azonenberg/freesample/README.md

# freesample
High performance sampling oscilloscope based on INTEGRALSTICK
