azonenberg/freesample/boards/freesample/freesample.kicad_pcb

## KiCad design boards/freesample/freesample.kicad_pcb (2019-04-01)

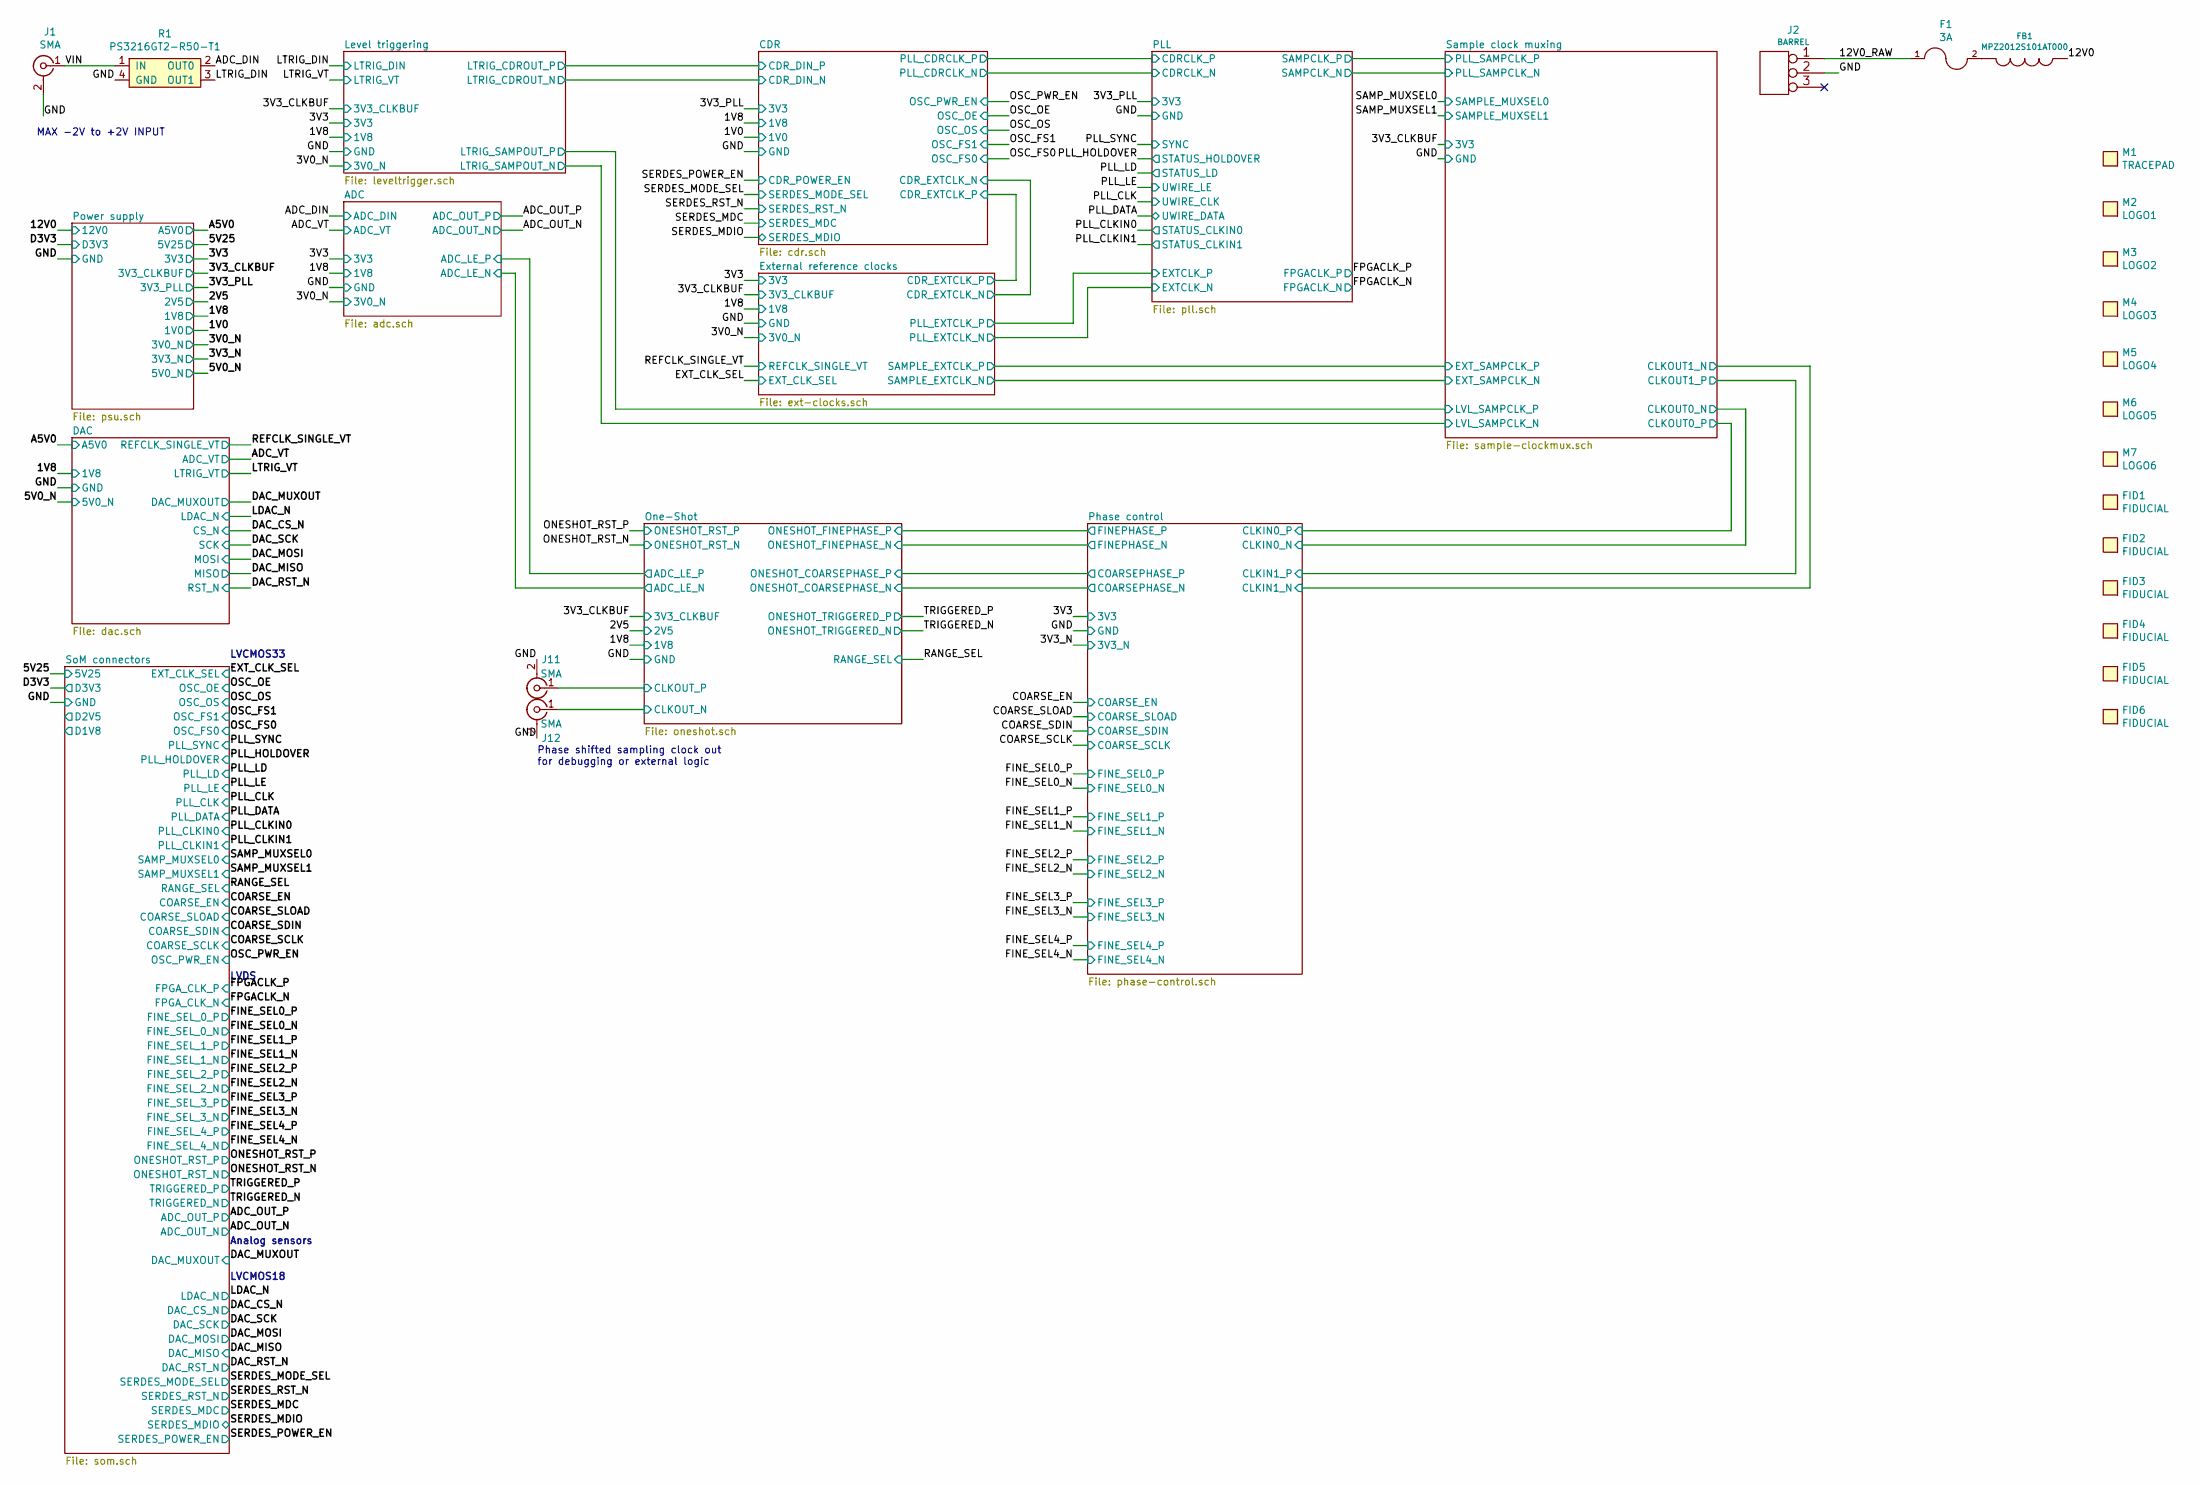
[picture p1: schematic freesample.sch, FREESAMPLE Oscilloscope]

Parts:
F1: 3A; EIA_0603_RES_NOSILK
FB1: MPZ2012S101AT000; EIA_0805_CAP_NOSILK
FID1, FID2, FID3, FID4, FID5, FID6: FIDUCIAL; FIDUCIAL_1MM
J1, J11, J12: SMA; CONN_SMA_EDGE_SAMTEC_SMA_J_P_H_ST_EM1
J2: BARREL; CONN_CUI_PJ-058BH_HIPWR_BARREL_NOSLOT
M1: TRACEPAD; SERIALNUM_MOLEX_0916580020
M2: LOGO1; LONGTHING-1200DPI
M3: LOGO2; Logo_silk_OSHW_6x6mm
M4: LOGO3; Logo_silk_polarity_center_5x1.4mm
M5: LOGO4; Logo_silk_ROHS_5x2.8mm
M6: LOGO5; Logo_silk_warning_5x4.2mm
M7: LOGO6; Logo_silk_WEEE_3.4x5mm
R1: PS3216GT2-R50-T1‎; SPLITTER_SUSUMU_PS3216G

Connections:
/12V0: FB1.1; also elsewhere on the board
/12V0_RAW: F1.1, J2.1
/ADC_DIN: R1.2 (OUT0); also elsewhere on the board
/GND: J1.2 (Ext), J2.2 (PM), J11.2 (Ext), J12.2 (Ext), R1.4 (GND); also elsewhere on the board
/LTRIG_DIN: R1.3 (OUT1); also elsewhere on the board
/One-Shot/CLKOUT_N: J12.1 (In); also elsewhere on the board
/One-Shot/CLKOUT_P: J11.1 (In); also elsewhere on the board
/VIN: J1.1 (In), R1.1 (IN)
unnamed: F1.2, FB1.2

Notes on the sheet:
LVCMOS33
Analog sensors
LVCMOS18
MAX -2V to +2V INPUT
LVDS
Phase shifted sampling clock out for debugging or external logic

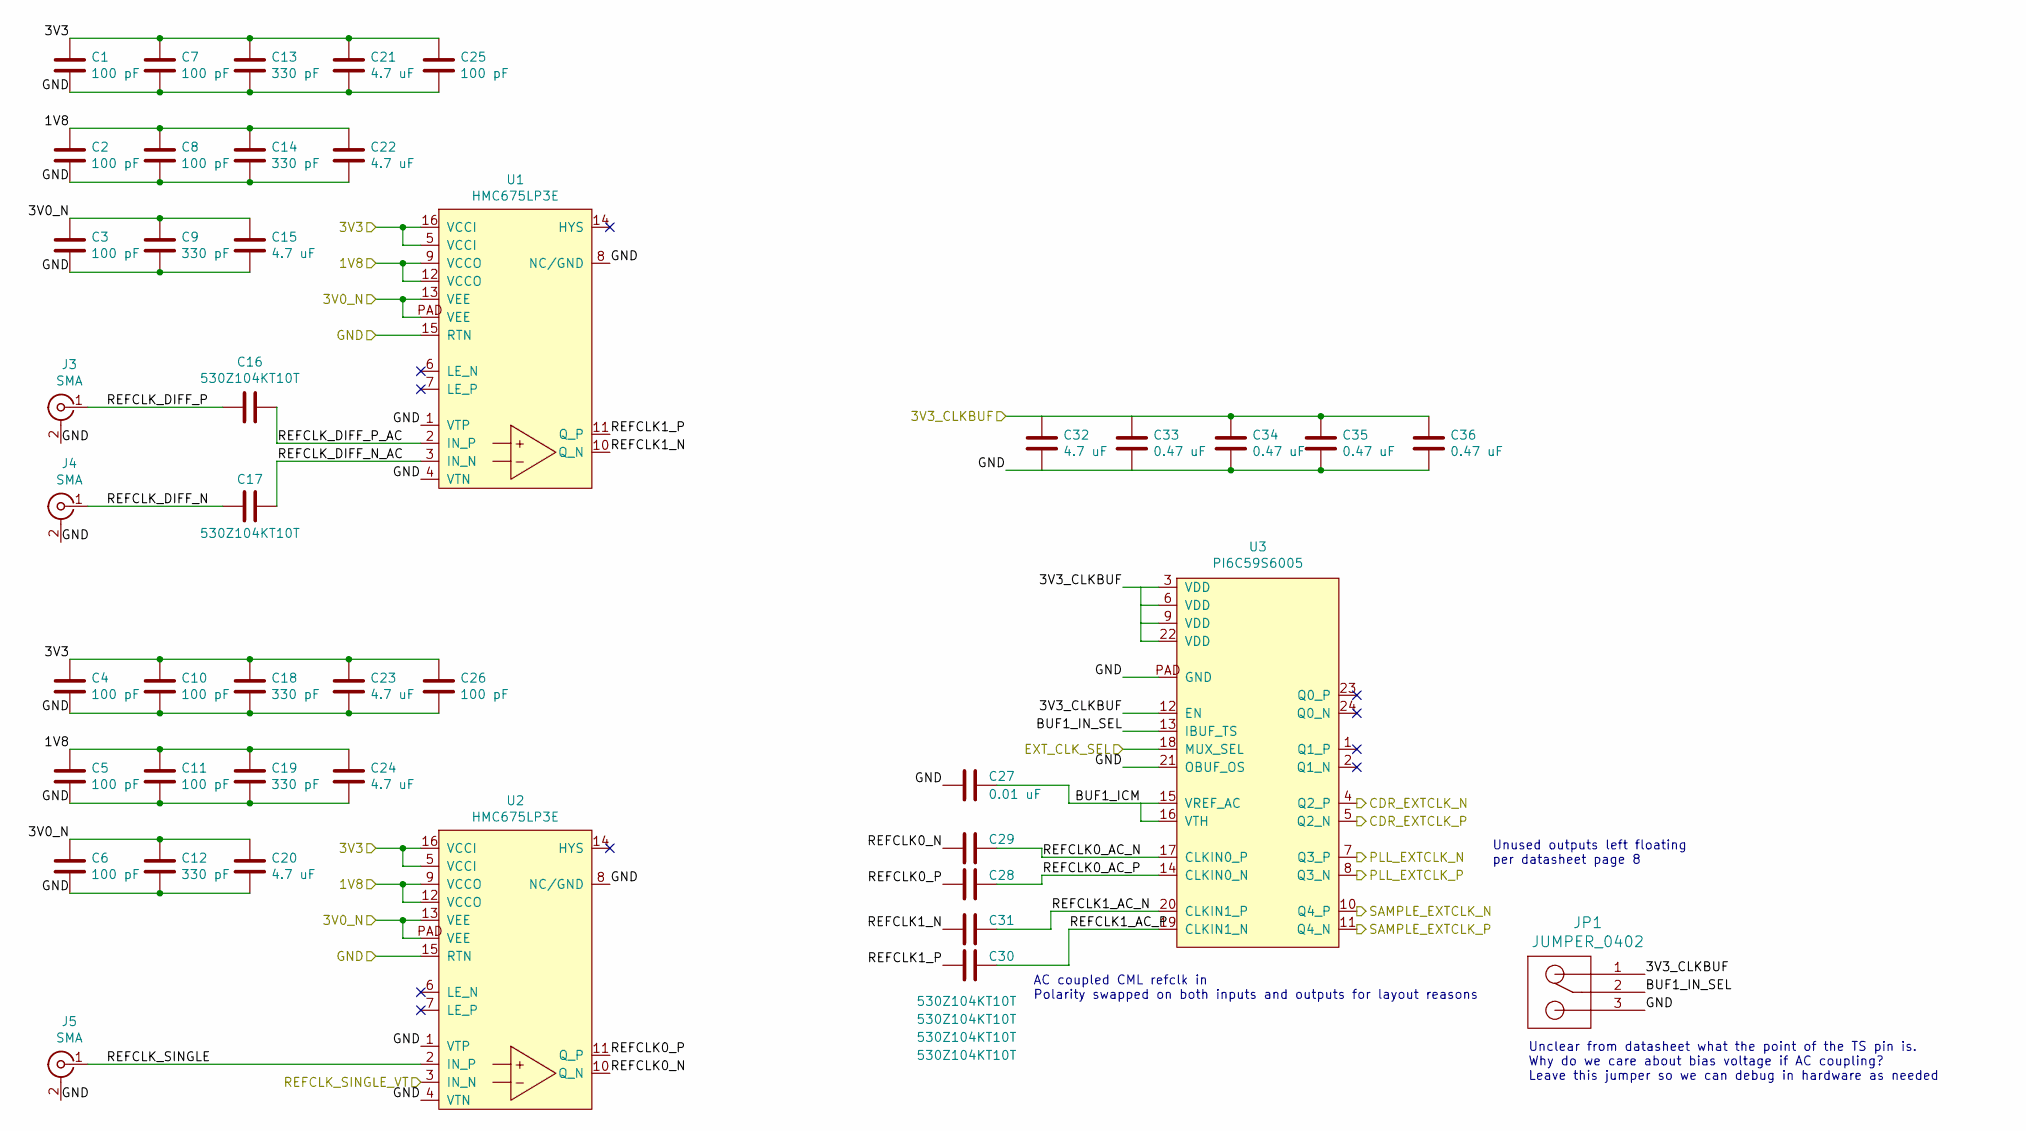
[picture p2: schematic ext-clocks.sch, FREESAMPLE Oscilloscope]

Parts:
C1, C2, C3, C4, C5, C6, C7, C8, C10, C11, C25, C26: 100 pF; EIA_0201_CAP_NOSILK
C9, C12, C13, C14, C18, C19: 330 pF; EIA_0201_CAP_NOSILK
C15, C20, C21, C22, C23, C24, C32: 4.7 uF; EIA_0603_CAP_NOSILK
C16, C17, C28, C29, C30, C31: 530Z104KT10T; EIA_0201_CAP_NOSILK
C27: 0.01 uF; EIA_0402_CAP_NOSILK
C33, C34, C35, C36: 0.47 uF; EIA_0402_CAP_NOSILK
J3, J4, J5: SMA; CONN_SMA_EDGE_SAMTEC_SMA_J_P_H_ST_EM1
JP1: JUMPER_0402; EIA_0402_JUMPER
U1, U2: HMC675LP3E; QFN_16_0.5MM_3x3MM
U3: PI6C59S6005; QFN_24_0.5MM_4x4MM

Connections:
/1V8: C2.1, C5.1, C8.1, C11.1, C14.1, C19.1, C22.1, C24.1, U1.9 (VCCO), U1.12 (VCCO), U2.9 (VCCO), U2.12 (VCCO); also elsewhere on the board
/3V0_N: C3.1, C6.1, C9.1, C12.1, C15.1, C20.1, U1.13 (VEE), U1.PAD (VEE), U2.13 (VEE), U2.PAD (VEE); also elsewhere on the board
/3V3: C1.1, C4.1, C7.1, C10.1, C13.1, C18.1, C21.1, C23.1, C25.1, C26.1, U1.5 (VCCI), U1.16 (VCCI), U2.5 (VCCI), U2.16 (VCCI); also elsewhere on the board
/3V3_CLKBUF: C32.1, C33.1, C34.1, C35.1, C36.1, JP1.1, U3.3 (VDD), U3.6 (VDD), U3.9 (VDD), U3.12 (EN), U3.22 (VDD); also elsewhere on the board
/CDR/CDR_EXTCLK_N: U3.4 (Q2_P); also elsewhere on the board
/CDR/CDR_EXTCLK_P: U3.5 (Q2_N); also elsewhere on the board
/EXT_CLK_SEL: U3.18 (MUX_SEL); also elsewhere on the board
/External reference clocks/BUF1_ICM: C27.1, U3.15 (VREF_AC), U3.16 (VTH)
/External reference clocks/BUF1_IN_SEL: JP1.2, U3.13 (IBUF_TS)
/External reference clocks/REFCLK0_AC_N: C29.1, U3.17 (CLKIN0_P)
/External reference clocks/REFCLK0_AC_P: C28.1, U3.14 (CLKIN0_N)
/External reference clocks/REFCLK0_N: C29.2, U2.10 (Q_N)
/External reference clocks/REFCLK0_P: C28.2, U2.11 (Q_P)
/External reference clocks/REFCLK1_AC_N: C31.1, U3.20 (CLKIN1_P)
/External reference clocks/REFCLK1_AC_P: C30.1, U3.19 (CLKIN1_N)
/External reference clocks/REFCLK1_N: C31.2, U1.10 (Q_N)
/External reference clocks/REFCLK1_P: C30.2, U1.11 (Q_P)
/External reference clocks/REFCLK_DIFF_N: C17.2, J4.1 (In)
/External reference clocks/REFCLK_DIFF_N_AC: C17.1, U1.3 (IN_N)
/External reference clocks/REFCLK_DIFF_P: C16.2, J3.1 (In)
/External reference clocks/REFCLK_DIFF_P_AC: C16.1, U1.2 (IN_P)
/External reference clocks/REFCLK_SINGLE: J5.1 (In), U2.2 (IN_P)
/GND: C1.2, C2.2, C3.2, C4.2, C5.2, C6.2, C7.2, C8.2, C9.2, C10.2, C11.2, C12.2, C13.2, C14.2, C15.2, C18.2, C19.2, C20.2, C21.2, C22.2, C23.2, C24.2, C25.2, C26.2, C27.2, C32.2, C33.2, C34.2, C35.2, C36.2, J3.2 (Ext), J4.2 (Ext), J5.2 (Ext), JP1.3, U1.1 (VTP), U1.4 (VTN), U1.8 (NC/GND), U1.15 (RTN), U2.1 (VTP), U2.4 (VTN), U2.8 (NC/GND), U2.15 (RTN), U3.21 (OBUF_OS), U3.PAD (GND); also elsewhere on the board
/PLL/EXTCLK_N: U3.7 (Q3_P); also elsewhere on the board
/PLL/EXTCLK_P: U3.8 (Q3_N); also elsewhere on the board
/REFCLK_SINGLE_VT: U2.3 (IN_N); also elsewhere on the board
/Sample clock muxing/EXT_SAMPCLK_N: U3.10 (Q4_P); also elsewhere on the board
/Sample clock muxing/EXT_SAMPCLK_P: U3.11 (Q4_N); also elsewhere on the board

Notes on the sheet:
AC coupled CML refclk in Polarity swapped on both inputs and outputs for layout reasons
Unused outputs left floating per datasheet page 8
Unclear from datasheet what the point of the TS pin is. Why do we care about bias voltage if AC coupling? Leave this jumper so we can debug in hardware as needed

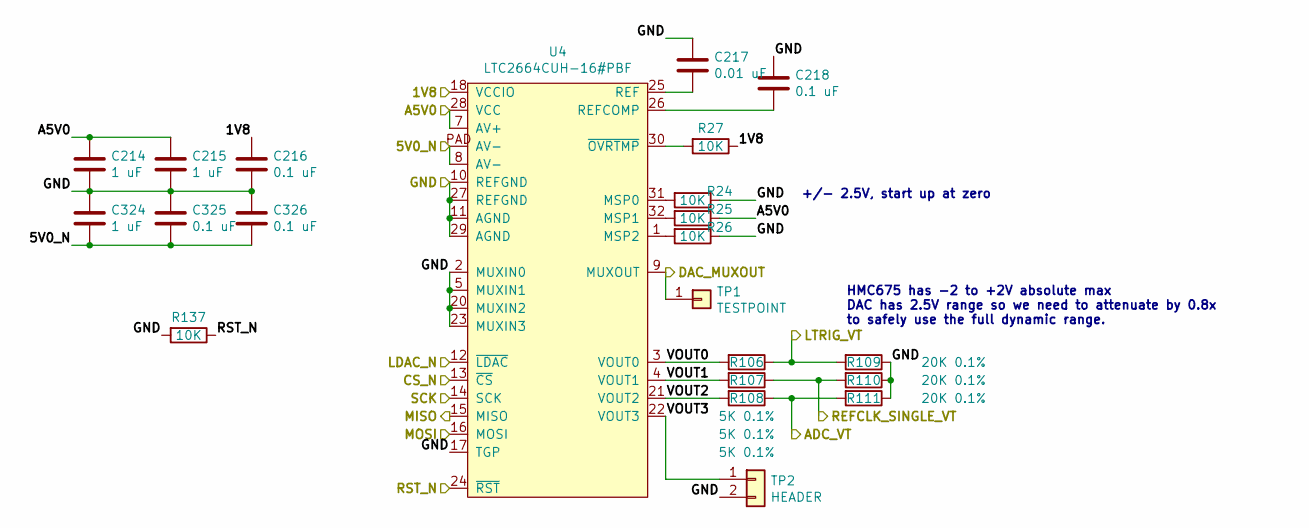
[picture p3: schematic dac.sch, FREESAMPLE Oscilloscope]

Parts:
C214, C215, C324: 1 uF; EIA_0603_CAP_NOSILK
C216, C218, C325, C326: 0.1 uF; EIA_0402_CAP_NOSILK
C217: 0.01 uF; EIA_0402_CAP_NOSILK
R24, R25, R26, R27, R137: 10K; EIA_0402_RES_NOSILK
R106, R107, R108: 5K 0.1%; EIA_0402_RES_NOSILK
R109, R110, R111: 20K 0.1%; EIA_0402_RES_NOSILK
TP1: TESTPOINT; TESTPOINT_SMT_KEYSTONE_5016
TP2: HEADER; CONN_HEADER_2.54MM_1x2
U4: LTC2664CUH-16#PBF; QFN_32_0.5MM_5x5MM

Connections:
/1V8: C216.1, R27.1, U4.18 (VCCIO); also elsewhere on the board
/5V0_N: C324.2, C325.2, C326.2, U4.8 (AV-), U4.PAD (AV-); also elsewhere on the board
/A5V0: C214.1, C215.1, R25.1, U4.7 (AV+), U4.28 (VCC); also elsewhere on the board
/ADC_VT: R108.1, R111.2; also elsewhere on the board
/DAC/VOUT0: R106.2, U4.3 (VOUT0)
/DAC/VOUT1: R107.2, U4.4 (VOUT1)
/DAC/VOUT2: R108.2, U4.21 (VOUT2)
/DAC/VOUT3: TP2.1, U4.22 (VOUT3)
/DAC_CS_N: U4.13 (~CS); also elsewhere on the board
/DAC_MISO: U4.15 (MISO); also elsewhere on the board
/DAC_MOSI: U4.16 (MOSI); also elsewhere on the board
/DAC_MUXOUT: TP1.1, U4.9 (MUXOUT); also elsewhere on the board
/DAC_RST_N: R137.1, U4.24 (~RST); also elsewhere on the board
/DAC_SCK: U4.14 (SCK); also elsewhere on the board
/GND: C214.2, C215.2, C216.2, C217.1, C218.1, C324.1, C325.1, C326.1, R24.1, R26.1, R109.1, R110.1, R111.1, R137.2, TP2.2, U4.2 (MUXIN0), U4.5 (MUXIN1), U4.10 (REFGND), U4.11 (AGND), U4.17 (TGP), U4.20 (MUXIN2), U4.23 (MUXIN3), U4.27 (REFGND), U4.29 (AGND); also elsewhere on the board
/LDAC_N: U4.12 (~LDAC); also elsewhere on the board
/LTRIG_VT: R106.1, R109.2; also elsewhere on the board
/REFCLK_SINGLE_VT: R107.1, R110.2; also elsewhere on the board
unnamed: C217.2, U4.25 (REF)
unnamed: C218.2, U4.26 (REFCOMP)
unnamed: R24.2, U4.31 (MSP0)
unnamed: R25.2, U4.32 (MSP1)
unnamed: R26.2, U4.1 (MSP2)
unnamed: R27.2, U4.30 (~OVRTMP)

Notes on the sheet:
+/- 2.5V, start up at zero
HMC675 has -2 to +2V absolute max DAC has 2.5V range so we need to attenuate by 0.8x to safely use the full dynamic range.

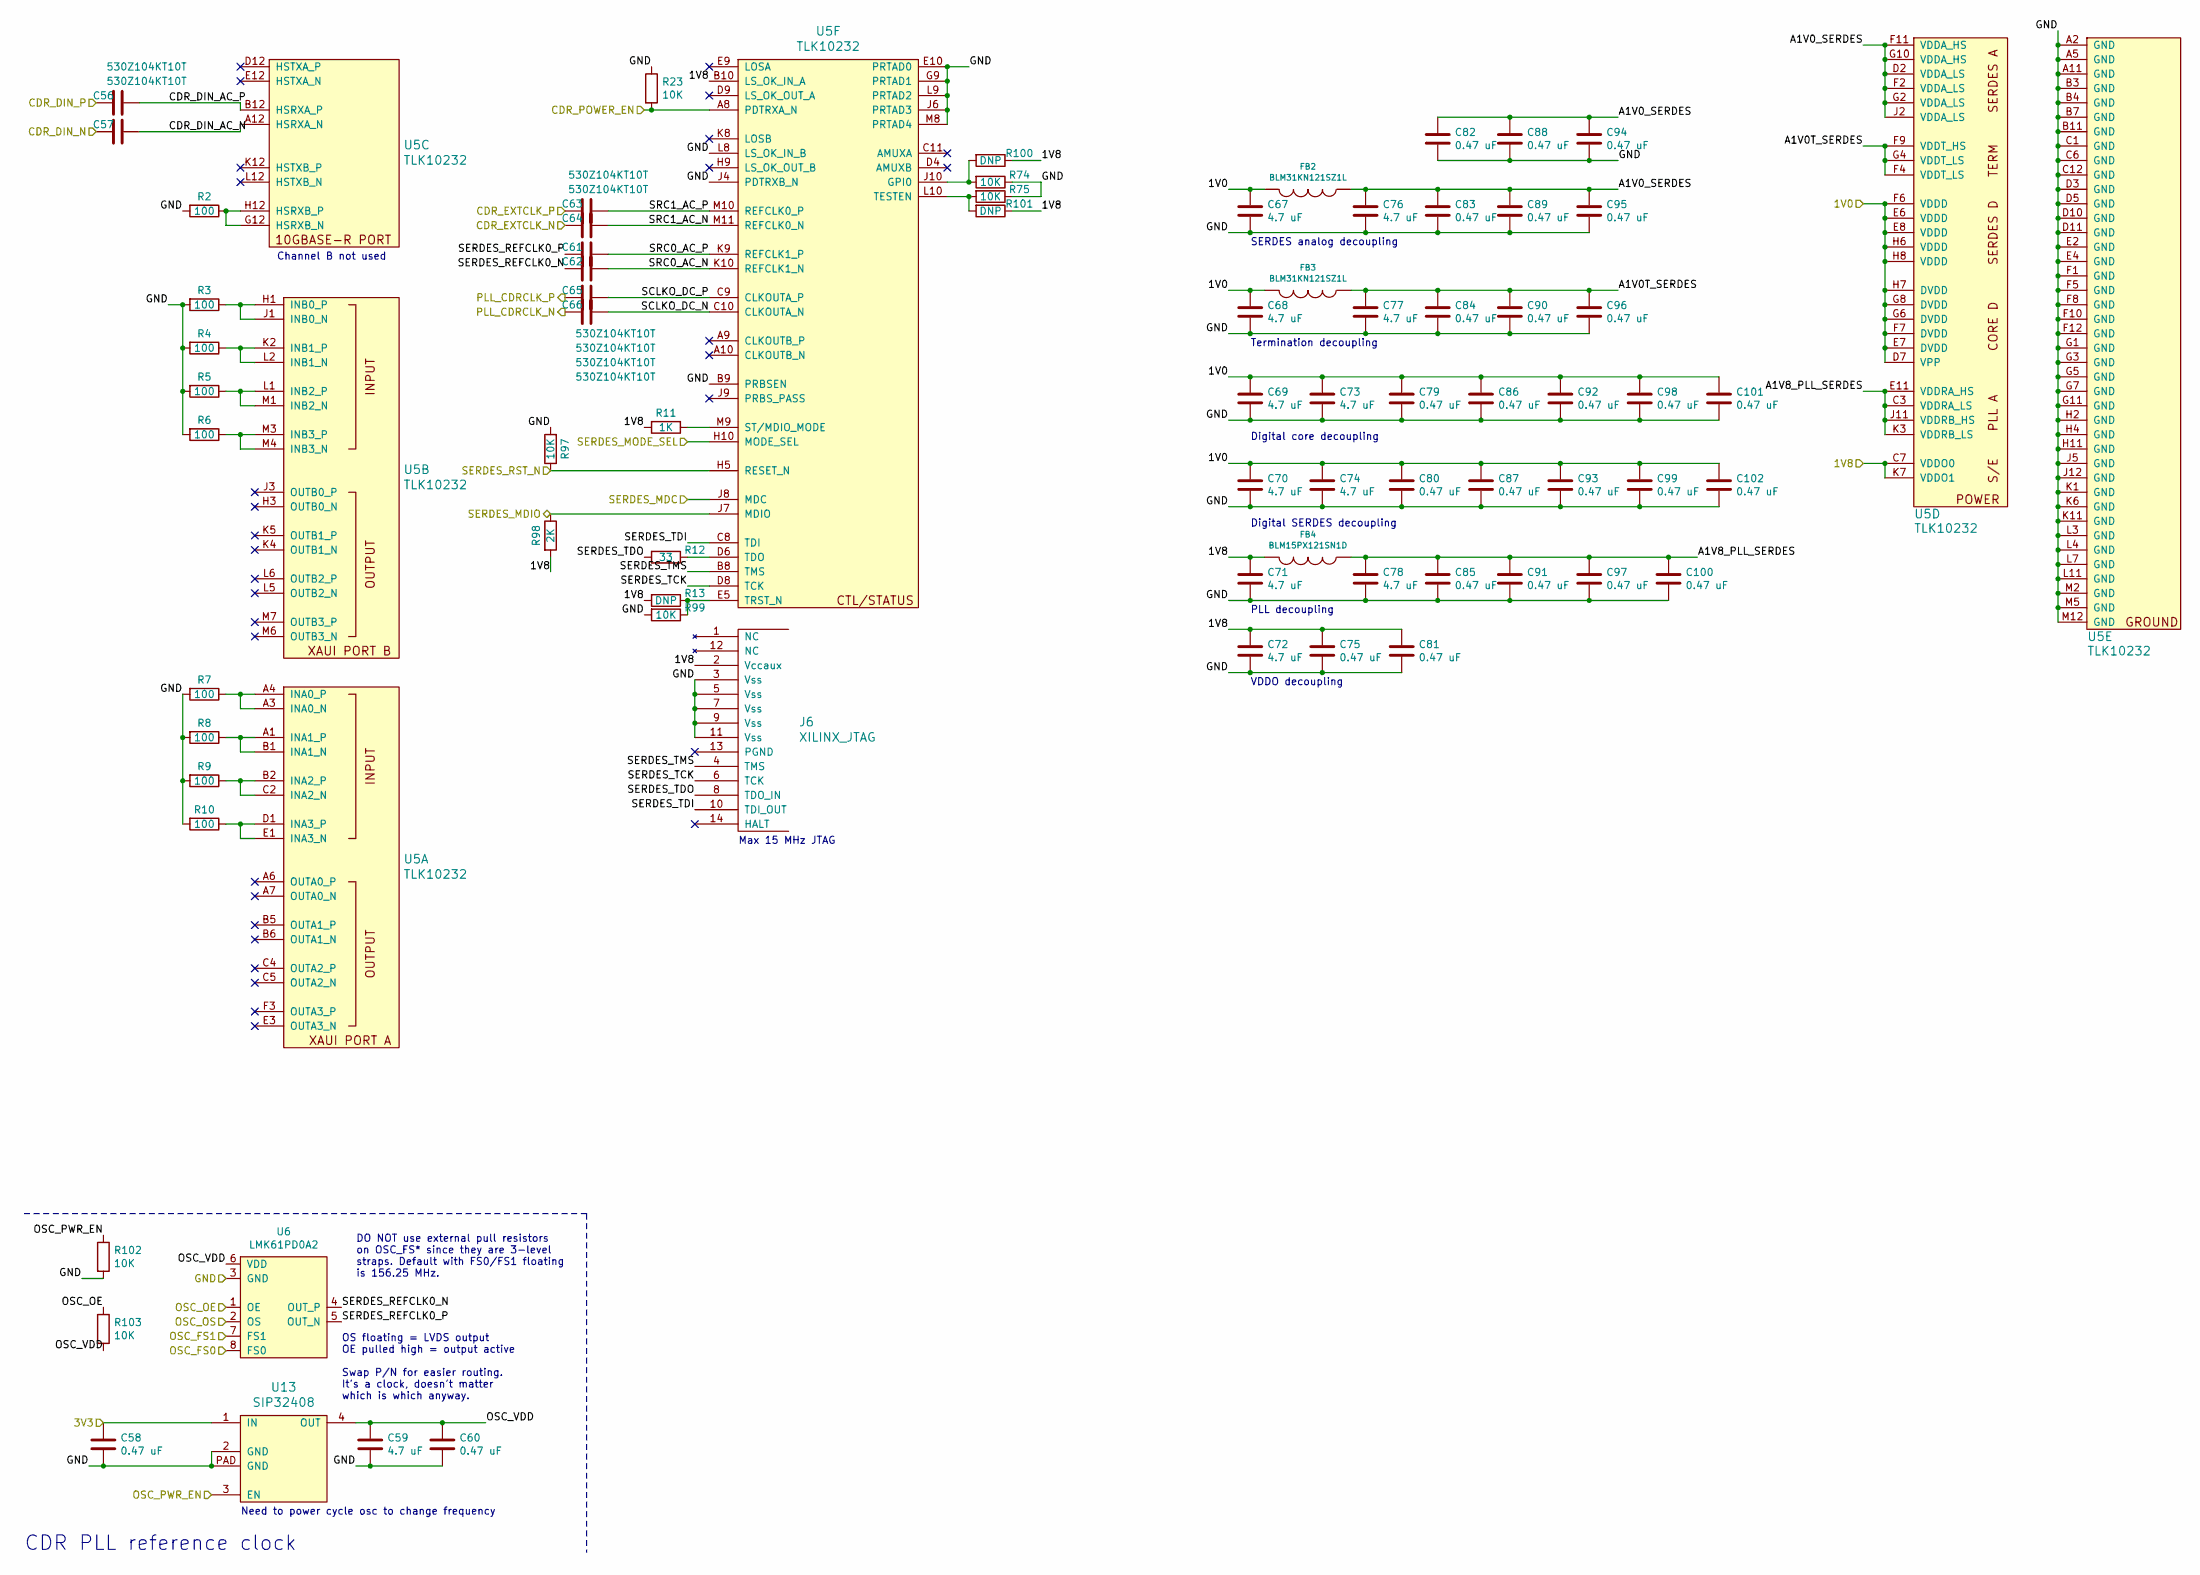
[picture p4: schematic cdr.sch, FREESAMPLE Oscilloscope]

Parts:
C56, C57, C61, C62, C63, C64, C65, C66: 530Z104KT10T; EIA_0201_CAP_NOSILK
C58, C60, C75, C79, C80, C81, C82, C83, C84, C85, C86, C87, C88, C89, C90, C91, C92, C93, C94, C95, C96, C97, C98, C99, C100, C101, C102: 0.47 uF; EIA_0402_CAP_NOSILK
C59, C67, C68, C69, C70, C71, C72, C73, C74, C76, C77, C78: 4.7 uF; EIA_0603_CAP_NOSILK
FB2, FB3: BLM31KN121SZ1L; EIA_1206_CAP_NOSILK
FB4: BLM15PX121SN1D; EIA_0402_CAP_NOSILK
J6: XILINX_JTAG; XILINX_JTAG_PTH_MOLEX_0878311420
R2, R3, R4, R5, R6, R7, R8, R9, R10: 100; EIA_0402_RES_NOSILK
R11: 1K; EIA_0402_RES_NOSILK
R12: 33; EIA_0402_RES_NOSILK
R13, R100, R101: DNP; EIA_0402_RES_NOSILK
R23, R74, R75, R97, R99, R102, R103: 10K; EIA_0402_RES_NOSILK
R98: 2K; EIA_0402_RES_NOSILK
U5: TLK10232; BGA_144_13x13_FULLARRAY_1MM
U6: LMK61PD0A2; QFN_8_5x7MM_TI_SIA
U13: SIP32408; DFN_4_0.5MM_1.6x1.2MM

Connections:
/1V0: C67.1, C68.1, C69.1, C70.1, C73.1, C74.1, C79.1, C80.1, C86.1, C87.1, C92.1, C93.1, C98.1, C99.1, C101.1, C102.1, FB2.2, FB3.2, U5.D7 (VPP), U5.E6 (VDDD), U5.E7 (DVDD), U5.E8 (VDDD), U5.F6 (VDDD), U5.F7 (DVDD), U5.G6 (DVDD), U5.G8 (DVDD), U5.H6 (VDDD), U5.H7 (DVDD), U5.H8 (VDDD); also elsewhere on the board
/1V8: C71.1, C72.1, C75.1, C81.1, FB4.2, J6.2 (Vccaux), R11.2, R13.2, R98.2, R100.1, R101.1, U5.B10 (LS_OK_IN_A), U5.C7 (VDDO0), U5.K7 (VDDO1); also elsewhere on the board
/3V3_PLL: C58.1, U13.1 (IN); also elsewhere on the board
/CDR/A1V0T_SERDES: C77.1, C84.1, C90.1, C96.1, FB3.1, U5.F4 (VDDT_LS), U5.F9 (VDDT_HS), U5.G4 (VDDT_LS)
/CDR/A1V0_SERDES: C76.1, C82.1, C83.1, C88.1, C89.1, C94.1, C95.1, FB2.1, U5.D2 (VDDA_LS), U5.F2 (VDDA_LS), U5.F11 (VDDA_HS), U5.G2 (VDDA_LS), U5.G10 (VDDA_HS), U5.J2 (VDDA_LS)
/CDR/A1V8_PLL_SERDES: C78.1, C85.1, C91.1, C97.1, C100.1, FB4.1, U5.C3 (VDDRA_LS), U5.E11 (VDDRA_HS), U5.J11 (VDDRB_HS), U5.K3 (VDDRB_LS)
/CDR/CDR_DIN_AC_N: C57.1, U5.A12 (HSRXA_N)
/CDR/CDR_DIN_AC_P: C56.1, U5.B12 (HSRXA_P)
/CDR/CDR_DIN_N: C57.2; also elsewhere on the board
/CDR/CDR_DIN_P: C56.2; also elsewhere on the board
/CDR/CDR_EXTCLK_N: C64.2; also elsewhere on the board
/CDR/CDR_EXTCLK_P: C63.2; also elsewhere on the board
/CDR/OSC_VDD: C59.1, C60.1, R103.2, U6.6 (VDD), U13.4 (OUT)
/CDR/SCLKO_DC_N: C66.1, U5.C10 (CLKOUTA_N)
/CDR/SCLKO_DC_P: C65.1, U5.C9 (CLKOUTA_P)
/CDR/SERDES_REFCLK0_N: C62.2, U6.4 (OUT_P)
/CDR/SERDES_REFCLK0_P: C61.2, U6.5 (OUT_N)
/CDR/SERDES_TCK: J6.6 (TCK), U5.D8 (TCK)
/CDR/SERDES_TDI: J6.10 (TDI_OUT), U5.C8 (TDI)
/CDR/SERDES_TDO: J6.8 (TDO_IN), R12.2
/CDR/SERDES_TMS: J6.4 (TMS), U5.B8 (TMS)
/CDR/SRC0_AC_N: C62.1, U5.K10 (REFCLK1_N)
/CDR/SRC0_AC_P: C61.1, U5.K9 (REFCLK1_P)
/CDR/SRC1_AC_N: C64.1, U5.M11 (REFCLK0_N)
/CDR/SRC1_AC_P: C63.1, U5.M10 (REFCLK0_P)
/GND: C58.2, C59.2, C60.2, C67.2, C68.2, C69.2, C70.2, C71.2, C72.2, C73.2, C74.2, C75.2, C76.2, C77.2, C78.2, C79.2, C80.2, C81.2, C82.2, C83.2, C84.2, C85.2, C86.2, C87.2, C88.2, C89.2, C90.2, C91.2, C92.2, C93.2, C94.2, C95.2, C96.2, C97.2, C98.2, C99.2, C100.2, C101.2, C102.2, J6.3 (Vss), J6.5 (Vss), J6.7 (Vss), J6.9 (Vss), J6.11 (Vss), R2.2, R3.2, R4.2, R5.2, R6.2, R7.2, R8.2, R9.2, R10.2, R23.1, R74.1, R75.1, R97.2, R99.2, R102.2, U5.A2 (GND), U5.A5 (GND), U5.A11 (GND), U5.B3 (GND), U5.B4 (GND), U5.B7 (GND), U5.B9 (PRBSEN), U5.B11 (GND), U5.C1 (GND), U5.C6 (GND), U5.C12 (GND), U5.D3 (GND), U5.D5 (GND), U5.D10 (GND), U5.D11 (GND), U5.E2 (GND), U5.E4 (GND), U5.E10 (PRTAD0), U5.F1 (GND), U5.F5 (GND), U5.F8 (GND), U5.F10 (GND), U5.F12 (GND), U5.G1 (GND), U5.G3 (GND), U5.G5 (GND), U5.G7 (GND), U5.G9 (PRTAD1), U5.G11 (GND), U5.H2 (GND), U5.H4 (GND), U5.H11 (GND), U5.J4 (PDTRXB_N), U5.J5 (GND), U5.J6 (PRTAD3), U5.J12 (GND), U5.K1 (GND), U5.K6 (GND), U5.K11 (GND), U5.L3 (GND), U5.L4 (GND), U5.L7 (GND), U5.L8 (LS_OK_IN_B), U5.L9 (PRTAD2), U5.L11 (GND), U5.M2 (GND), U5.M5 (GND), U5.M8 (PRTAD4), U5.M12 (GND), U6.3 (GND), U13.2 (GND), U13.PAD (GND); also elsewhere on the board
/OSC_FS0: U6.8 (FS0); also elsewhere on the board
/OSC_FS1: U6.7 (FS1); also elsewhere on the board
/OSC_OE: R103.1, U6.1 (OE); also elsewhere on the board
/OSC_OS: U6.2 (OS); also elsewhere on the board
/OSC_PWR_EN: R102.1, U13.3 (EN); also elsewhere on the board
/PLL/CDRCLK_N: C66.2; also elsewhere on the board
/PLL/CDRCLK_P: C65.2; also elsewhere on the board
/SERDES_MDC: U5.J8 (MDC); also elsewhere on the board
/SERDES_MDIO: R98.1, U5.J7 (MDIO); also elsewhere on the board
/SERDES_MODE_SEL: U5.H10 (MODE_SEL); also elsewhere on the board
/SERDES_POWER_EN: R23.2, U5.A8 (PDTRXA_N); also elsewhere on the board
/SERDES_RST_N: R97.1, U5.H5 (RESET_N); also elsewhere on the board
unnamed: R2.1, U5.G12 (HSRXB_N), U5.H12 (HSRXB_P)
unnamed: R3.1, U5.H1 (INB0_P), U5.J1 (INB0_N)
unnamed: R4.1, U5.K2 (INB1_P), U5.L2 (INB1_N)
unnamed: R5.1, U5.L1 (INB2_P), U5.M1 (INB2_N)
unnamed: R6.1, U5.M3 (INB3_P), U5.M4 (INB3_N)
unnamed: R7.1, U5.A3 (INA0_N), U5.A4 (INA0_P)
unnamed: R8.1, U5.A1 (INA1_P), U5.B1 (INA1_N)
unnamed: R9.1, U5.B2 (INA2_P), U5.C2 (INA2_N)
unnamed: R10.1, U5.D1 (INA3_P), U5.E1 (INA3_N)
unnamed: R11.1, U5.M9 (ST/MDIO_MODE)
unnamed: R12.1, U5.D6 (TDO)
unnamed: R13.1, R99.1, U5.E5 (TRST_N)
unnamed: R74.2, R100.2, U5.J10 (GPI0)
unnamed: R75.2, R101.2, U5.L10 (TESTEN)

Notes on the sheet:
Channel B not used
Need to power cycle osc to change frequency
Max 15 MHz JTAG
VDDO decoupling
PLL decoupling
Digital SERDES decoupling
Digital core decoupling
Termination decoupling
SERDES analog decoupling
CDR PLL reference clock
DO NOT use external pull resistors on OSC_FS* since they are 3-level straps. Default with FS0/FS1 floating is 156.25 MHz.
OS floating = LVDS output OE pulled high = output active Swap P/N for easier routing. It's a clock, doesn't matter which is which anyway.

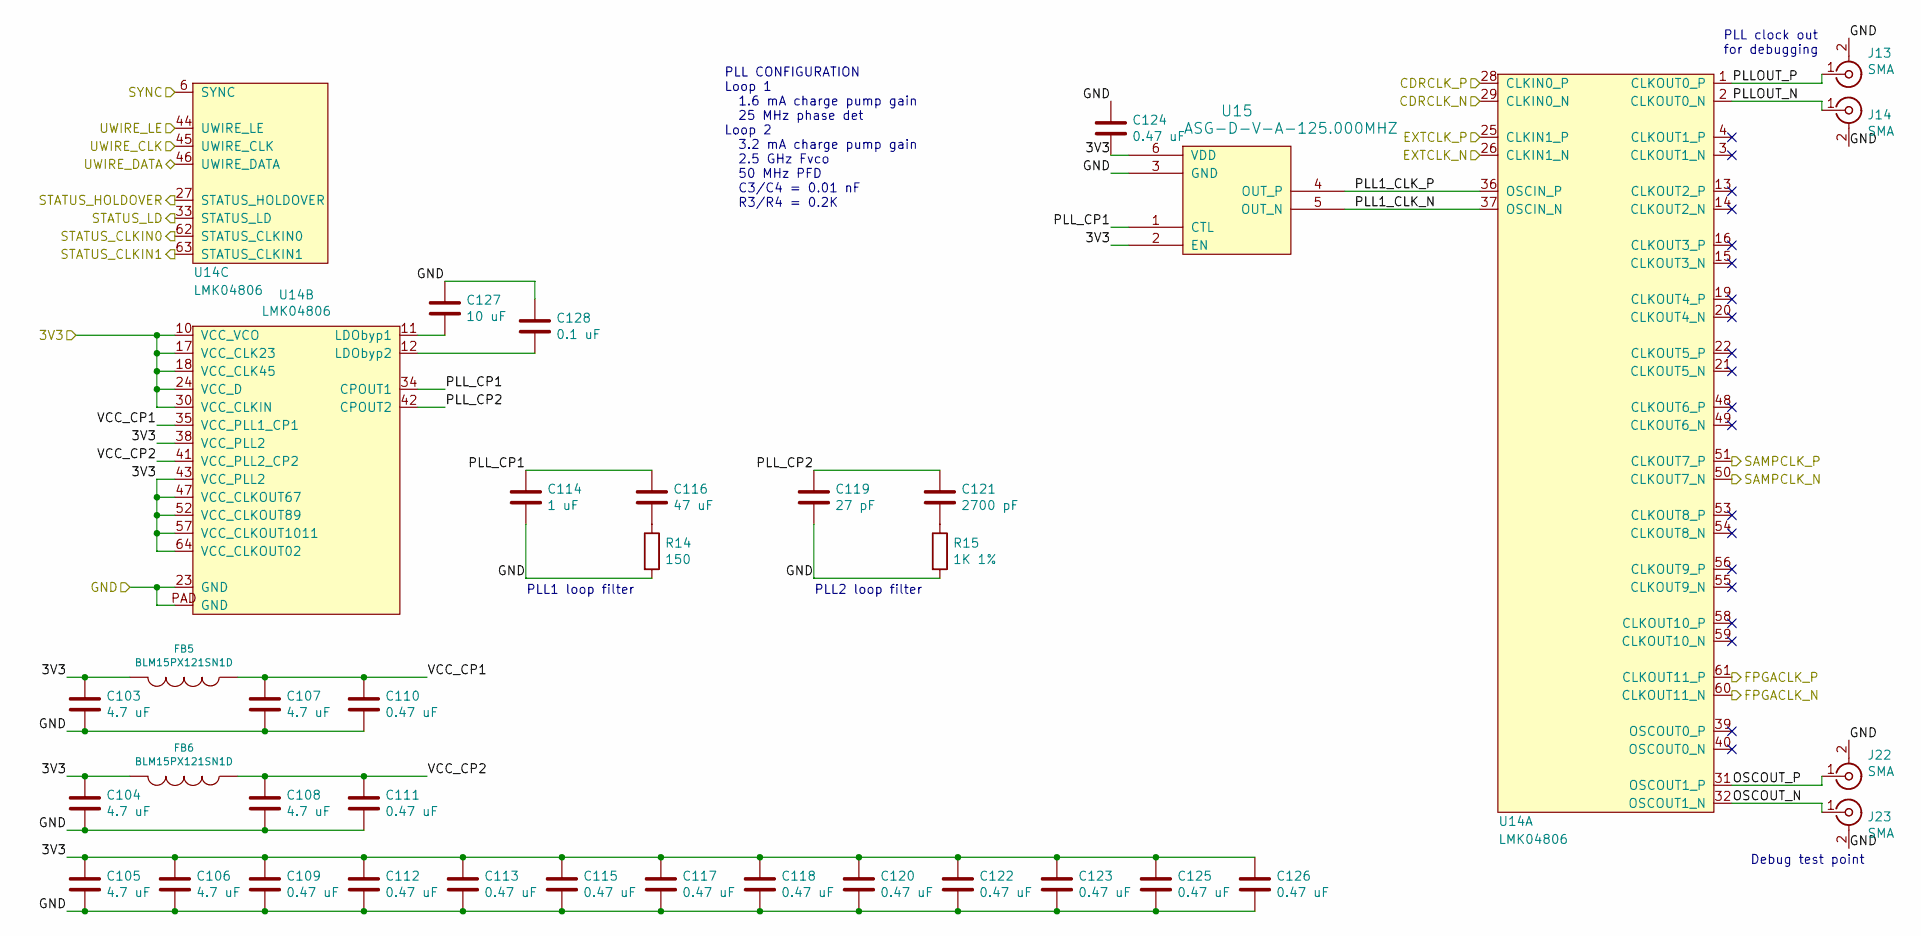
[picture p5: schematic pll.sch, FREESAMPLE Oscilloscope]

Parts:
C103, C104, C105, C106, C107, C108: 4.7 uF; EIA_0603_CAP_NOSILK
C109, C110, C111, C112, C113, C115, C117, C118, C120, C122, C123, C124, C125, C126: 0.47 uF; EIA_0402_CAP_NOSILK
C114: 1 uF; EIA_0402_CAP_NOSILK
C116: 47 uF; EIA_1210_CAP_NOSILK
C119: 27 pF; EIA_0402_CAP_NOSILK
C121: 2700 pF; EIA_0402_CAP_NOSILK
C127: 10 uF; EIA_1206_CAP_NOSILK
C128: 0.1 uF; EIA_0402_CAP_NOSILK
FB5, FB6: BLM15PX121SN1D; EIA_0402_CAP_NOSILK
J13, J14, J22, J23: SMA; CONN_SMA_EDGE_SAMTEC_SMA_J_P_H_ST_EM1
R14: 150; EIA_0402_RES_NOSILK
R15: 1K 1%; EIA_0402_RES_NOSILK
U14: LMK04806; QFN_64_0.5MM_9x9MM
U15: ASG-D-V-A-125.000MHZ; VCXO_5x7MM_ASG_D

Connections:
/3V3_PLL: C103.1, C104.1, C105.1, C106.1, C109.1, C112.1, C113.1, C115.1, C117.1, C118.1, C120.1, C122.1, C123.1, C124.2, C125.1, C126.1, FB5.2, FB6.2, U14.10 (VCC_VCO), U14.17 (VCC_CLK23), U14.18 (VCC_CLK45), U14.24 (VCC_D), U14.30 (VCC_CLKIN), U14.38 (VCC_PLL2), U14.43 (VCC_PLL2), U14.47 (VCC_CLKOUT67), U14.52 (VCC_CLKOUT89), U14.57 (VCC_CLKOUT1011), U14.64 (VCC_CLKOUT02), U15.2 (EN), U15.6 (VDD); also elsewhere on the board
/FPGACLK_N: U14.60 (CLKOUT11_N); also elsewhere on the board
/FPGACLK_P: U14.61 (CLKOUT11_P); also elsewhere on the board
/GND: C103.2, C104.2, C105.2, C106.2, C107.2, C108.2, C109.2, C110.2, C111.2, C112.2, C113.2, C114.2, C115.2, C117.2, C118.2, C119.2, C120.2, C122.2, C123.2, C124.1, C125.2, C126.2, C127.1, C128.1, J13.2 (Ext), J14.2 (Ext), J22.2 (Ext), J23.2 (Ext), R14.2, R15.2, U14.23 (GND), U14.PAD (GND), U15.3 (GND); also elsewhere on the board
/PLL/CDRCLK_N: U14.29 (CLKIN0_N); also elsewhere on the board
/PLL/CDRCLK_P: U14.28 (CLKIN0_P); also elsewhere on the board
/PLL/EXTCLK_N: U14.26 (CLKIN1_N); also elsewhere on the board
/PLL/EXTCLK_P: U14.25 (CLKIN1_P); also elsewhere on the board
/PLL/OSCOUT_N: J23.1 (In), U14.32 (OSCOUT1_N)
/PLL/OSCOUT_P: J22.1 (In), U14.31 (OSCOUT1_P)
/PLL/PLL1_CLK_N: U14.37 (OSCIN_N), U15.5 (OUT_N)
/PLL/PLL1_CLK_P: U14.36 (OSCIN_P), U15.4 (OUT_P)
/PLL/PLLOUT_N: J14.1 (In), U14.2 (CLKOUT0_N)
/PLL/PLLOUT_P: J13.1 (In), U14.1 (CLKOUT0_P)
/PLL/PLL_CP1: C114.1, C116.1, U14.34 (CPOUT1), U15.1 (CTL)
/PLL/PLL_CP2: C119.1, C121.1, U14.42 (CPOUT2)
/PLL/VCC_CP1: C107.1, C110.1, FB5.1, U14.35 (VCC_PLL1_CP1)
/PLL/VCC_CP2: C108.1, C111.1, FB6.1, U14.41 (VCC_PLL2_CP2)
/PLL_CLK: U14.45 (UWIRE_CLK); also elsewhere on the board
/PLL_CLKIN0: U14.62 (STATUS_CLKIN0); also elsewhere on the board
/PLL_CLKIN1: U14.63 (STATUS_CLKIN1); also elsewhere on the board
/PLL_DATA: U14.46 (UWIRE_DATA); also elsewhere on the board
/PLL_HOLDOVER: U14.27 (STATUS_HOLDOVER); also elsewhere on the board
/PLL_LD: U14.33 (STATUS_LD); also elsewhere on the board
/PLL_LE: U14.44 (UWIRE_LE); also elsewhere on the board
/PLL_SYNC: U14.6 (SYNC); also elsewhere on the board
/Sample clock muxing/PLL_SAMPCLK_N: U14.50 (CLKOUT7_N); also elsewhere on the board
/Sample clock muxing/PLL_SAMPCLK_P: U14.51 (CLKOUT7_P); also elsewhere on the board
unnamed: C116.2, R14.1
unnamed: C121.2, R15.1
unnamed: C127.2, U14.11 (LDObyp1)
unnamed: C128.2, U14.12 (LDObyp2)

Notes on the sheet:
PLL CONFIGURATION Loop 1 1.6 mA charge pump gain 25 MHz phase det Loop 2 3.2 mA charge pump gain 2.5 GHz Fvco 50 MHz PFD C3/C4 = 0.01 nF R3/R4 = 0.2K
PLL clock out for debugging
Debug test point
PLL2 loop filter
PLL1 loop filter
