azonenberg/freesample/boards/freesample/freesample.kicad_pcb

## KiCad design boards/freesample/freesample.kicad_pcb (continued)

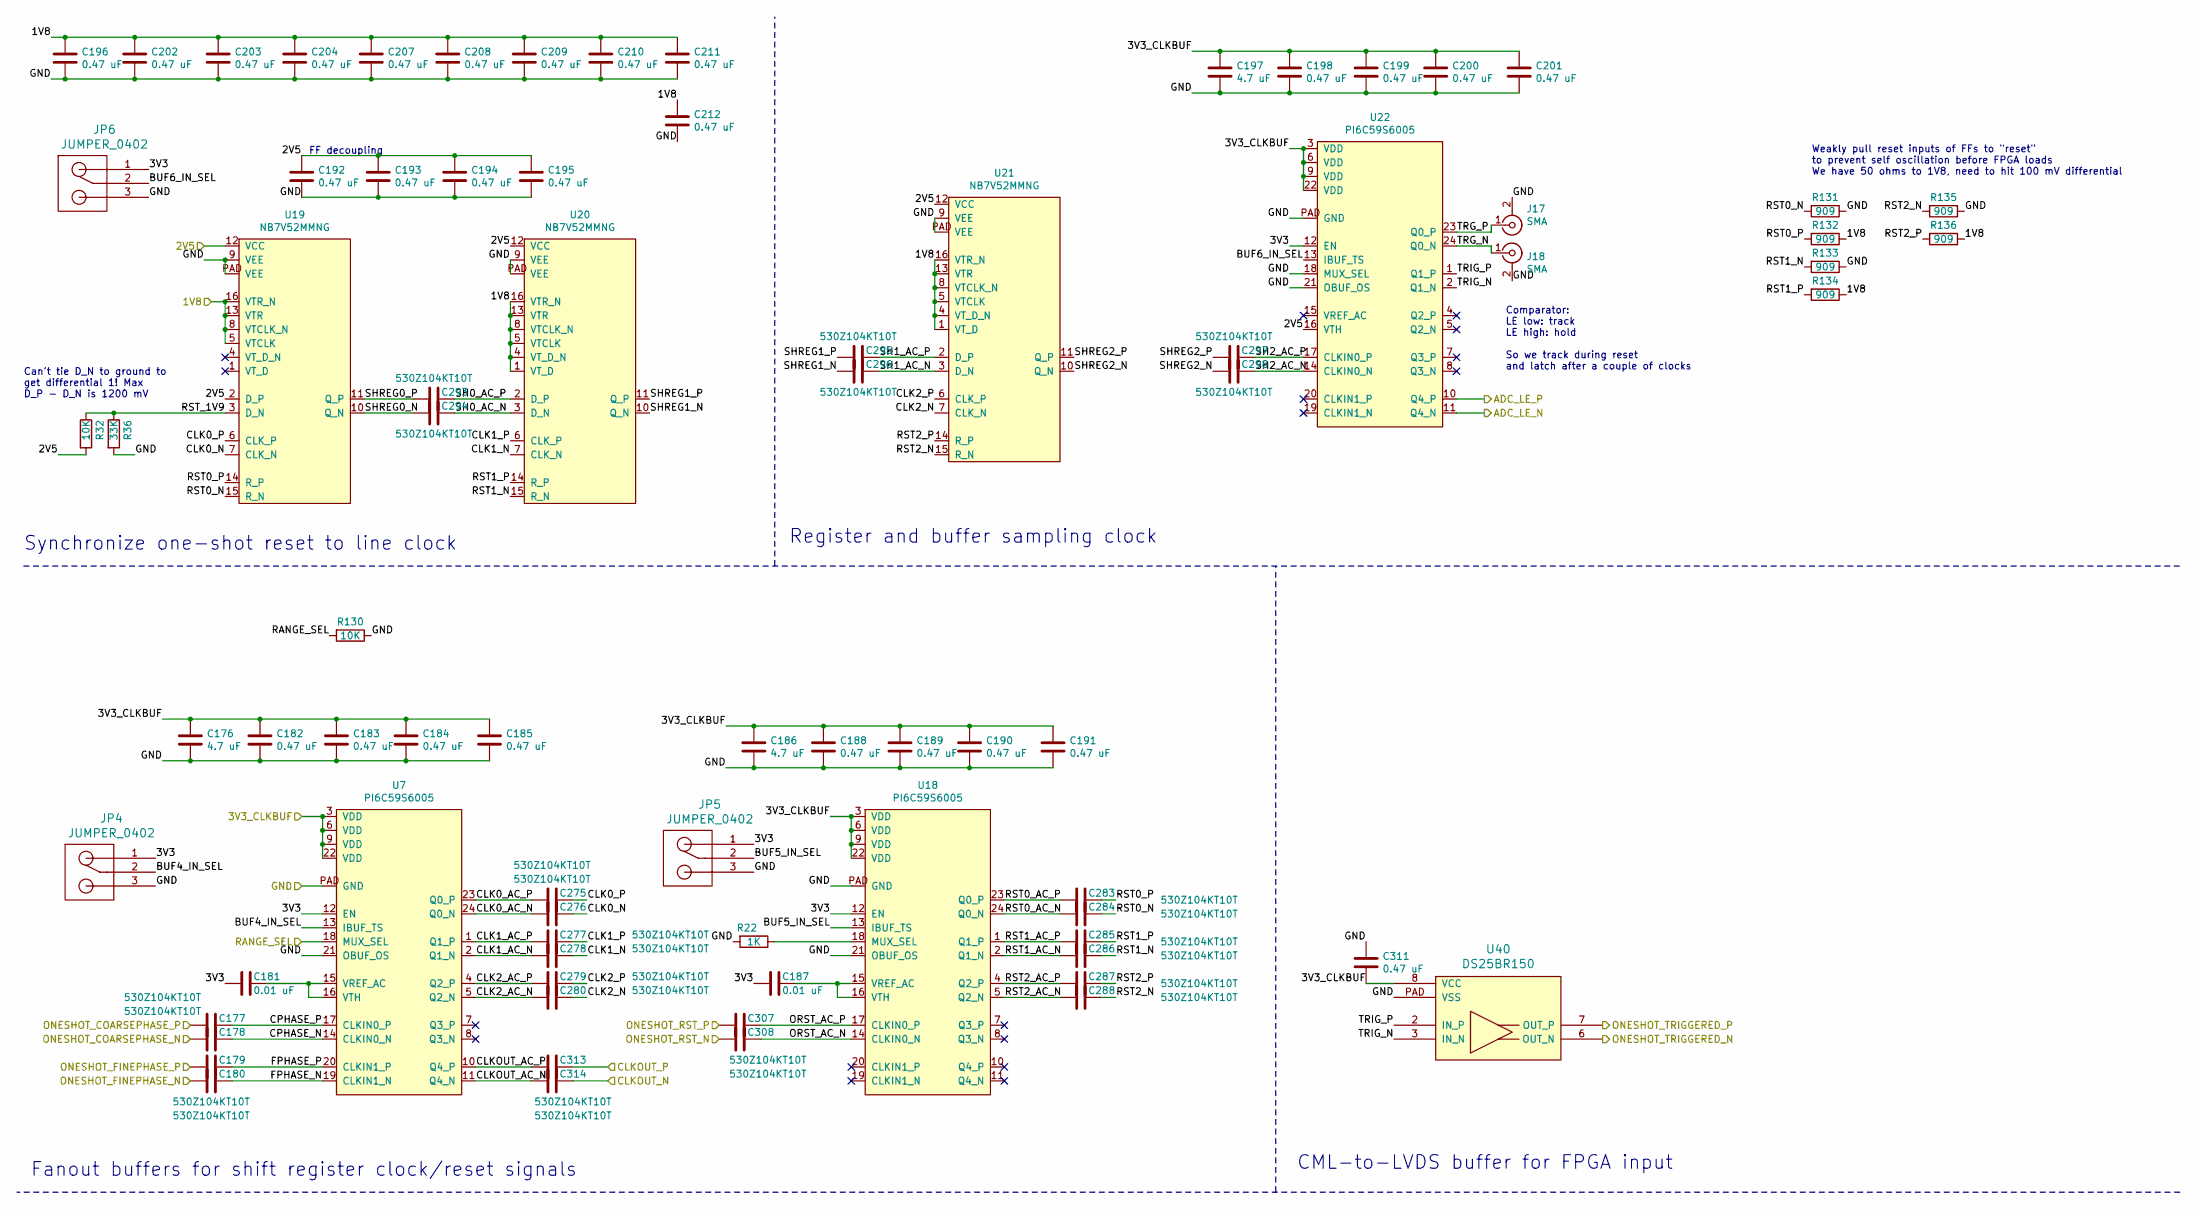
[picture p6: schematic oneshot.sch, FREESAMPLE Oscilloscope]

Parts:
C176, C186, C197: 4.7 uF; EIA_0603_CAP_NOSILK
C177, C178, C179, C180, C275, C276, C277, C278, C279, C280, C283, C284, C285, C286, C287, C288, C293, C294, C295, C296, C297, C298, C307, C308, C313, C314: 530Z104KT10T; EIA_0201_CAP_NOSILK
C181, C187: 0.01 uF; EIA_0402_CAP_NOSILK
C182, C183, C184, C185, C188, C189, C190, C191, C192, C193, C194, C195, C196, C198, C199, C200, C201, C202, C203, C204, C207, C208, C209, C210, C211, C212, C311: 0.47 uF; EIA_0402_CAP_NOSILK
J17, J18: SMA; CONN_SMA_EDGE_SAMTEC_SMA_J_P_H_ST_EM1
JP4, JP5, JP6: JUMPER_0402; EIA_0402_JUMPER
R22: 1K; EIA_0402_RES_NOSILK
R32, R130: 10K; EIA_0402_RES_NOSILK
R36: 33K; EIA_0402_RES_NOSILK
R131, R132, R133, R134, R135, R136: 909; EIA_0402_RES_NOSILK
U7, U18, U22: PI6C59S6005; QFN_24_0.5MM_4x4MM
U19, U20, U21: NB7V52MMNG; QFN_16_0.5MM_3x3MM
U40: DS25BR150; DFN_8_0.5MM_3x3MM

Connections:
/1V8: C196.1, C202.1, C203.1, C204.1, C207.1, C208.1, C209.1, C210.1, C211.1, C212.1, R132.1, R134.1, R136.1, U19.5 (VTCLK), U19.8 (VTCLK_N), U19.13 (VTR), U19.16 (VTR_N), U20.1 (VT_D), U20.4 (VT_D_N), U20.5 (VTCLK), U20.8 (VTCLK_N), U20.13 (VTR), U20.16 (VTR_N), U21.1 (VT_D), U21.4 (VT_D_N), U21.5 (VTCLK), U21.8 (VTCLK_N), U21.13 (VTR), U21.16 (VTR_N); also elsewhere on the board
/2V5: C192.1, C193.1, C194.1, C195.1, R32.2, U19.2 (D_P), U19.12 (VCC), U20.12 (VCC), U21.12 (VCC), U22.16 (VTH); also elsewhere on the board
/3V3_CLKBUF: C176.1, C182.1, C183.1, C184.1, C185.1, C186.1, C188.1, C189.1, C190.1, C191.1, C197.1, C198.1, C199.1, C200.1, C201.1, C311.2, U7.3 (VDD), U7.6 (VDD), U7.9 (VDD), U7.22 (VDD), U18.3 (VDD), U18.6 (VDD), U18.9 (VDD), U18.22 (VDD), U22.3 (VDD), U22.6 (VDD), U22.9 (VDD), U22.22 (VDD), U40.8 (VCC); also elsewhere on the board
/ADC/ADC_LE_N: U22.11 (Q4_N); also elsewhere on the board
/ADC/ADC_LE_P: U22.10 (Q4_P); also elsewhere on the board
/GND: C176.2, C182.2, C183.2, C184.2, C185.2, C186.2, C188.2, C189.2, C190.2, C191.2, C192.2, C193.2, C194.2, C195.2, C196.2, C197.2, C198.2, C199.2, C200.2, C201.2, C202.2, C203.2, C204.2, C207.2, C208.2, C209.2, C210.2, C211.2, C212.2, C311.1, J17.2 (Ext), J18.2 (Ext), JP4.3, JP5.3, JP6.3, R22.2, R36.2, R130.1, R131.1, R133.1, R135.1, U7.21 (OBUF_OS), U7.PAD (GND), U18.21 (OBUF_OS), U18.PAD (GND), U19.9 (VEE), U19.PAD (VEE), U20.9 (VEE), U20.PAD (VEE), U21.9 (VEE), U21.PAD (VEE), U22.18 (MUX_SEL), U22.21 (OBUF_OS), U22.PAD (GND), U40.PAD (VSS); also elsewhere on the board
/ONESHOT_RST_N: C308.2; also elsewhere on the board
/ONESHOT_RST_P: C307.2; also elsewhere on the board
/One-Shot/3V3: C181.2, C187.2, JP4.1, JP5.1, JP6.1, U7.12 (EN), U18.12 (EN), U22.12 (EN)
/One-Shot/BUF4_IN_SEL: JP4.2, U7.13 (IBUF_TS)
/One-Shot/BUF5_IN_SEL: JP5.2, U18.13 (IBUF_TS)
/One-Shot/BUF6_IN_SEL: JP6.2, U22.13 (IBUF_TS)
/One-Shot/CLK0_AC_N: C276.2, U7.24 (Q0_N)
/One-Shot/CLK0_AC_P: C275.2, U7.23 (Q0_P)
/One-Shot/CLK0_N: C276.1, U19.7 (CLK_N)
/One-Shot/CLK0_P: C275.1, U19.6 (CLK_P)
/One-Shot/CLK1_AC_N: C278.2, U7.2 (Q1_N)
/One-Shot/CLK1_AC_P: C277.2, U7.1 (Q1_P)
/One-Shot/CLK1_N: C278.1, U20.7 (CLK_N)
/One-Shot/CLK1_P: C277.1, U20.6 (CLK_P)
/One-Shot/CLK2_AC_N: C280.2, U7.5 (Q2_N)
/One-Shot/CLK2_AC_P: C279.2, U7.4 (Q2_P)
/One-Shot/CLK2_N: C280.1, U21.7 (CLK_N)
/One-Shot/CLK2_P: C279.1, U21.6 (CLK_P)
/One-Shot/CLKOUT_AC_N: C314.2, U7.11 (Q4_N)
/One-Shot/CLKOUT_AC_P: C313.2, U7.10 (Q4_P)
/One-Shot/CLKOUT_N: C314.1; also elsewhere on the board
/One-Shot/CLKOUT_P: C313.1; also elsewhere on the board
/One-Shot/CPHASE_N: C178.1, U7.14 (CLKIN0_N)
/One-Shot/CPHASE_P: C177.1, U7.17 (CLKIN0_P)
/One-Shot/FPHASE_N: C180.1, U7.19 (CLKIN1_N)
/One-Shot/FPHASE_P: C179.1, U7.20 (CLKIN1_P)
/One-Shot/ORST_AC_N: C308.1, U18.14 (CLKIN0_N)
/One-Shot/ORST_AC_P: C307.1, U18.17 (CLKIN0_P)
/One-Shot/RST0_AC_N: C284.2, U18.24 (Q0_N)
/One-Shot/RST0_AC_P: C283.2, U18.23 (Q0_P)
/One-Shot/RST0_N: C284.1, R131.2, U19.15 (R_N)
/One-Shot/RST0_P: C283.1, R132.2, U19.14 (R_P)
/One-Shot/RST1_AC_N: C286.2, U18.2 (Q1_N)
/One-Shot/RST1_AC_P: C285.2, U18.1 (Q1_P)
/One-Shot/RST1_N: C286.1, R133.2, U20.15 (R_N)
/One-Shot/RST1_P: C285.1, R134.2, U20.14 (R_P)
/One-Shot/RST2_AC_N: C288.2, U18.5 (Q2_N)
/One-Shot/RST2_AC_P: C287.2, U18.4 (Q2_P)
/One-Shot/RST2_N: C288.1, R135.2, U21.15 (R_N)
/One-Shot/RST2_P: C287.1, R136.2, U21.14 (R_P)
/One-Shot/RST_1V9: R32.1, R36.1, U19.3 (D_N)
/One-Shot/SH0_AC_N: C294.1, U20.3 (D_N)
/One-Shot/SH0_AC_P: C293.1, U20.2 (D_P)
/One-Shot/SH1_AC_N: C296.1, U21.3 (D_N)
/One-Shot/SH1_AC_P: C295.1, U21.2 (D_P)
/One-Shot/SH2_AC_N: C298.1, U22.14 (CLKIN0_N)
/One-Shot/SH2_AC_P: C297.1, U22.17 (CLKIN0_P)
/One-Shot/SHREG0_N: C294.2, U19.10 (Q_N)
/One-Shot/SHREG0_P: C293.2, U19.11 (Q_P)
/One-Shot/SHREG1_N: C296.2, U20.10 (Q_N)
/One-Shot/SHREG1_P: C295.2, U20.11 (Q_P)
/One-Shot/SHREG2_N: C298.2, U21.10 (Q_N)
/One-Shot/SHREG2_P: C297.2, U21.11 (Q_P)
/One-Shot/TRG_N: J18.1 (In), U22.24 (Q0_N)
/One-Shot/TRG_P: J17.1 (In), U22.23 (Q0_P)
/One-Shot/TRIG_N: U22.2 (Q1_N), U40.3 (IN_N)
/One-Shot/TRIG_P: U22.1 (Q1_P), U40.2 (IN_P)
/Phase control/COARSEPHASE_N: C178.2; also elsewhere on the board
/Phase control/COARSEPHASE_P: C177.2; also elsewhere on the board
/Phase control/FINEPHASE_N: C180.2; also elsewhere on the board
/Phase control/FINEPHASE_P: C179.2; also elsewhere on the board
/RANGE_SEL: R130.2, U7.18 (MUX_SEL); also elsewhere on the board
/TRIGGERED_N: U40.6 (OUT_N); also elsewhere on the board
/TRIGGERED_P: U40.7 (OUT_P); also elsewhere on the board
unnamed: C181.1, U7.15 (VREF_AC), U7.16 (VTH)
unnamed: C187.1, U18.15 (VREF_AC), U18.16 (VTH)
unnamed: R22.1, U18.18 (MUX_SEL)

Notes on the sheet:
FF decoupling
Synchronize one-shot reset to line clock
Register and buffer sampling clock
Can't tie D_N to ground to get differential 1! Max D_P - D_N is 1200 mV
CML-to-LVDS buffer for FPGA input
Comparator: LE low: track LE high: hold So we track during reset and latch after a couple of clocks
Fanout buffers for shift register clock/reset signals
Weakly pull reset inputs of FFs to "reset" to prevent self oscillation before FPGA loads We have 50 ohms to 1V8, need to hit 100 mV differential

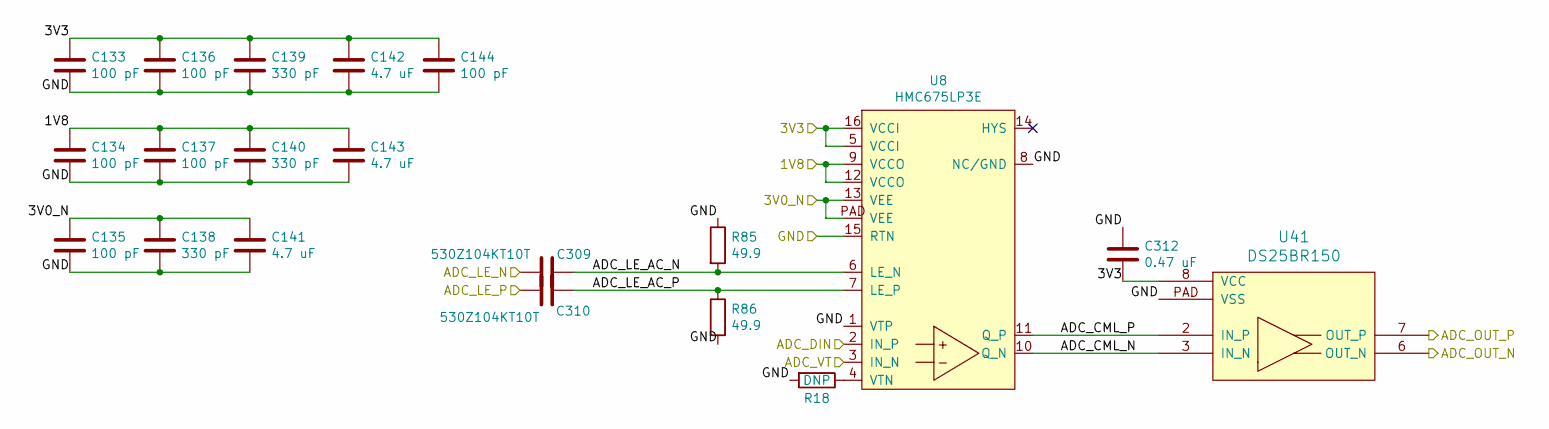
[picture p7: schematic adc.sch, FREESAMPLE Oscilloscope]

Parts:
C133, C134, C135, C136, C137, C144: 100 pF; EIA_0201_CAP_NOSILK
C138, C139, C140: 330 pF; EIA_0201_CAP_NOSILK
C141, C142, C143: 4.7 uF; EIA_0603_CAP_NOSILK
C309, C310: 530Z104KT10T; EIA_0201_CAP_NOSILK
C312: 0.47 uF; EIA_0402_CAP_NOSILK
R18: DNP; EIA_0402_RES_NOSILK
R85, R86: 49.9; EIA_0402_RES_NOSILK
U8: HMC675LP3E; QFN_16_0.5MM_3x3MM
U41: DS25BR150; DFN_8_0.5MM_3x3MM

Connections:
/1V8: C134.1, C137.1, C140.1, C143.1, U8.9 (VCCO), U8.12 (VCCO); also elsewhere on the board
/3V0_N: C135.1, C138.1, C141.1, U8.13 (VEE), U8.PAD (VEE); also elsewhere on the board
/3V3: C133.1, C136.1, C139.1, C142.1, C144.1, C312.2, U8.5 (VCCI), U8.16 (VCCI), U41.8 (VCC); also elsewhere on the board
/ADC/ADC_CML_N: U8.10 (Q_N), U41.3 (IN_N)
/ADC/ADC_CML_P: U8.11 (Q_P), U41.2 (IN_P)
/ADC/ADC_LE_AC_N: C309.1, R85.2, U8.6 (LE_N)
/ADC/ADC_LE_AC_P: C310.1, R86.1, U8.7 (LE_P)
/ADC/ADC_LE_N: C309.2; also elsewhere on the board
/ADC/ADC_LE_P: C310.2; also elsewhere on the board
/ADC_DIN: U8.2 (IN_P); also elsewhere on the board
/ADC_OUT_N: U41.6 (OUT_N); also elsewhere on the board
/ADC_OUT_P: U41.7 (OUT_P); also elsewhere on the board
/ADC_VT: U8.3 (IN_N); also elsewhere on the board
/GND: C133.2, C134.2, C135.2, C136.2, C137.2, C138.2, C139.2, C140.2, C141.2, C142.2, C143.2, C144.2, C312.1, R18.2, R85.1, R86.2, U8.1 (VTP), U8.8 (NC/GND), U8.15 (RTN), U41.PAD (VSS); also elsewhere on the board
unnamed: R18.1, U8.4 (VTN)

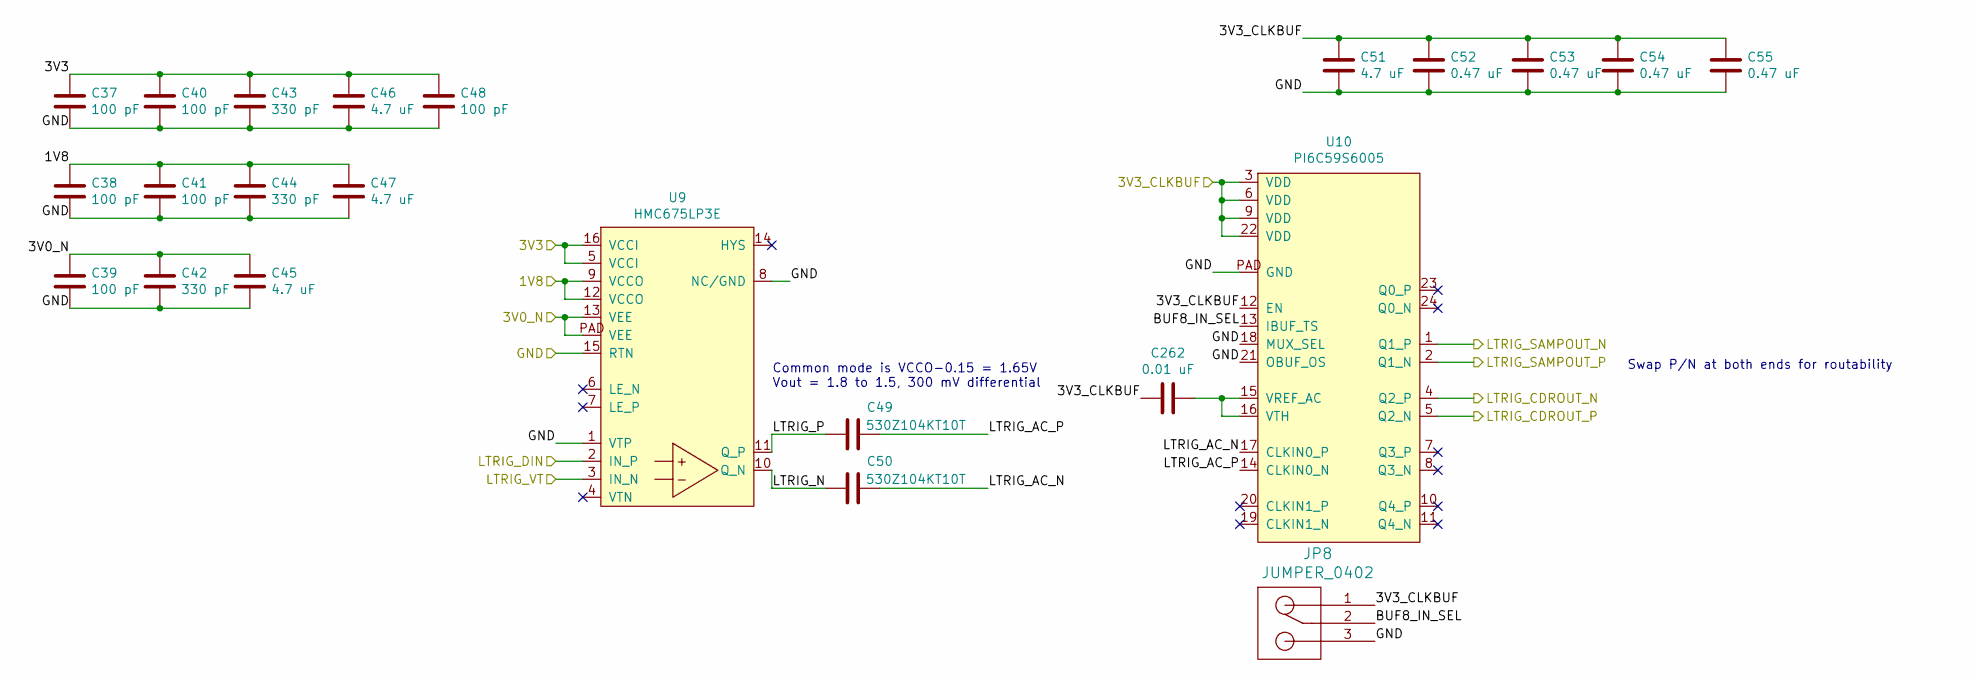
[picture p8: schematic leveltrigger.sch, FREESAMPLE Oscilloscope]

Parts:
C37, C38, C39, C40, C41, C48: 100 pF; EIA_0201_CAP_NOSILK
C42, C43, C44: 330 pF; EIA_0201_CAP_NOSILK
C45, C46, C47, C51: 4.7 uF; EIA_0603_CAP_NOSILK
C49, C50: 530Z104KT10T; EIA_0201_CAP_NOSILK
C52, C53, C54, C55: 0.47 uF; EIA_0402_CAP_NOSILK
C262: 0.01 uF; EIA_0402_CAP_NOSILK
JP8: JUMPER_0402; EIA_0402_JUMPER
U9: HMC675LP3E; QFN_16_0.5MM_3x3MM
U10: PI6C59S6005; QFN_24_0.5MM_4x4MM

Connections:
/1V8: C38.1, C41.1, C44.1, C47.1, U9.9 (VCCO), U9.12 (VCCO); also elsewhere on the board
/3V0_N: C39.1, C42.1, C45.1, U9.13 (VEE), U9.PAD (VEE); also elsewhere on the board
/3V3: C37.1, C40.1, C43.1, C46.1, C48.1, U9.5 (VCCI), U9.16 (VCCI); also elsewhere on the board
/3V3_CLKBUF: C51.1, C52.1, C53.1, C54.1, C55.1, C262.2, JP8.1, U10.3 (VDD), U10.6 (VDD), U10.9 (VDD), U10.12 (EN), U10.22 (VDD); also elsewhere on the board
/CDR/CDR_DIN_N: U10.4 (Q2_P); also elsewhere on the board
/CDR/CDR_DIN_P: U10.5 (Q2_N); also elsewhere on the board
/GND: C37.2, C38.2, C39.2, C40.2, C41.2, C42.2, C43.2, C44.2, C45.2, C46.2, C47.2, C48.2, C51.2, C52.2, C53.2, C54.2, C55.2, JP8.3, U9.1 (VTP), U9.8 (NC/GND), U9.15 (RTN), U10.18 (MUX_SEL), U10.21 (OBUF_OS), U10.PAD (GND); also elsewhere on the board
/LTRIG_DIN: U9.2 (IN_P); also elsewhere on the board
/LTRIG_VT: U9.3 (IN_N); also elsewhere on the board
/Level triggering/BUF8_IN_SEL: JP8.2, U10.13 (IBUF_TS)
/Level triggering/LTRIG_AC_N: C50.1, U10.17 (CLKIN0_P)
/Level triggering/LTRIG_AC_P: C49.1, U10.14 (CLKIN0_N)
/Level triggering/LTRIG_N: C50.2, U9.10 (Q_N)
/Level triggering/LTRIG_P: C49.2, U9.11 (Q_P)
/Level triggering/LTRIG_SAMPOUT_N: U10.1 (Q1_P); also elsewhere on the board
/Level triggering/LTRIG_SAMPOUT_P: U10.2 (Q1_N); also elsewhere on the board
unnamed: C262.1, U10.15 (VREF_AC), U10.16 (VTH)

Notes on the sheet:
Common mode is VCCO-0.15 = 1.65V Vout = 1.8 to 1.5, 300 mV differential
Swap P/N at both ends for routability

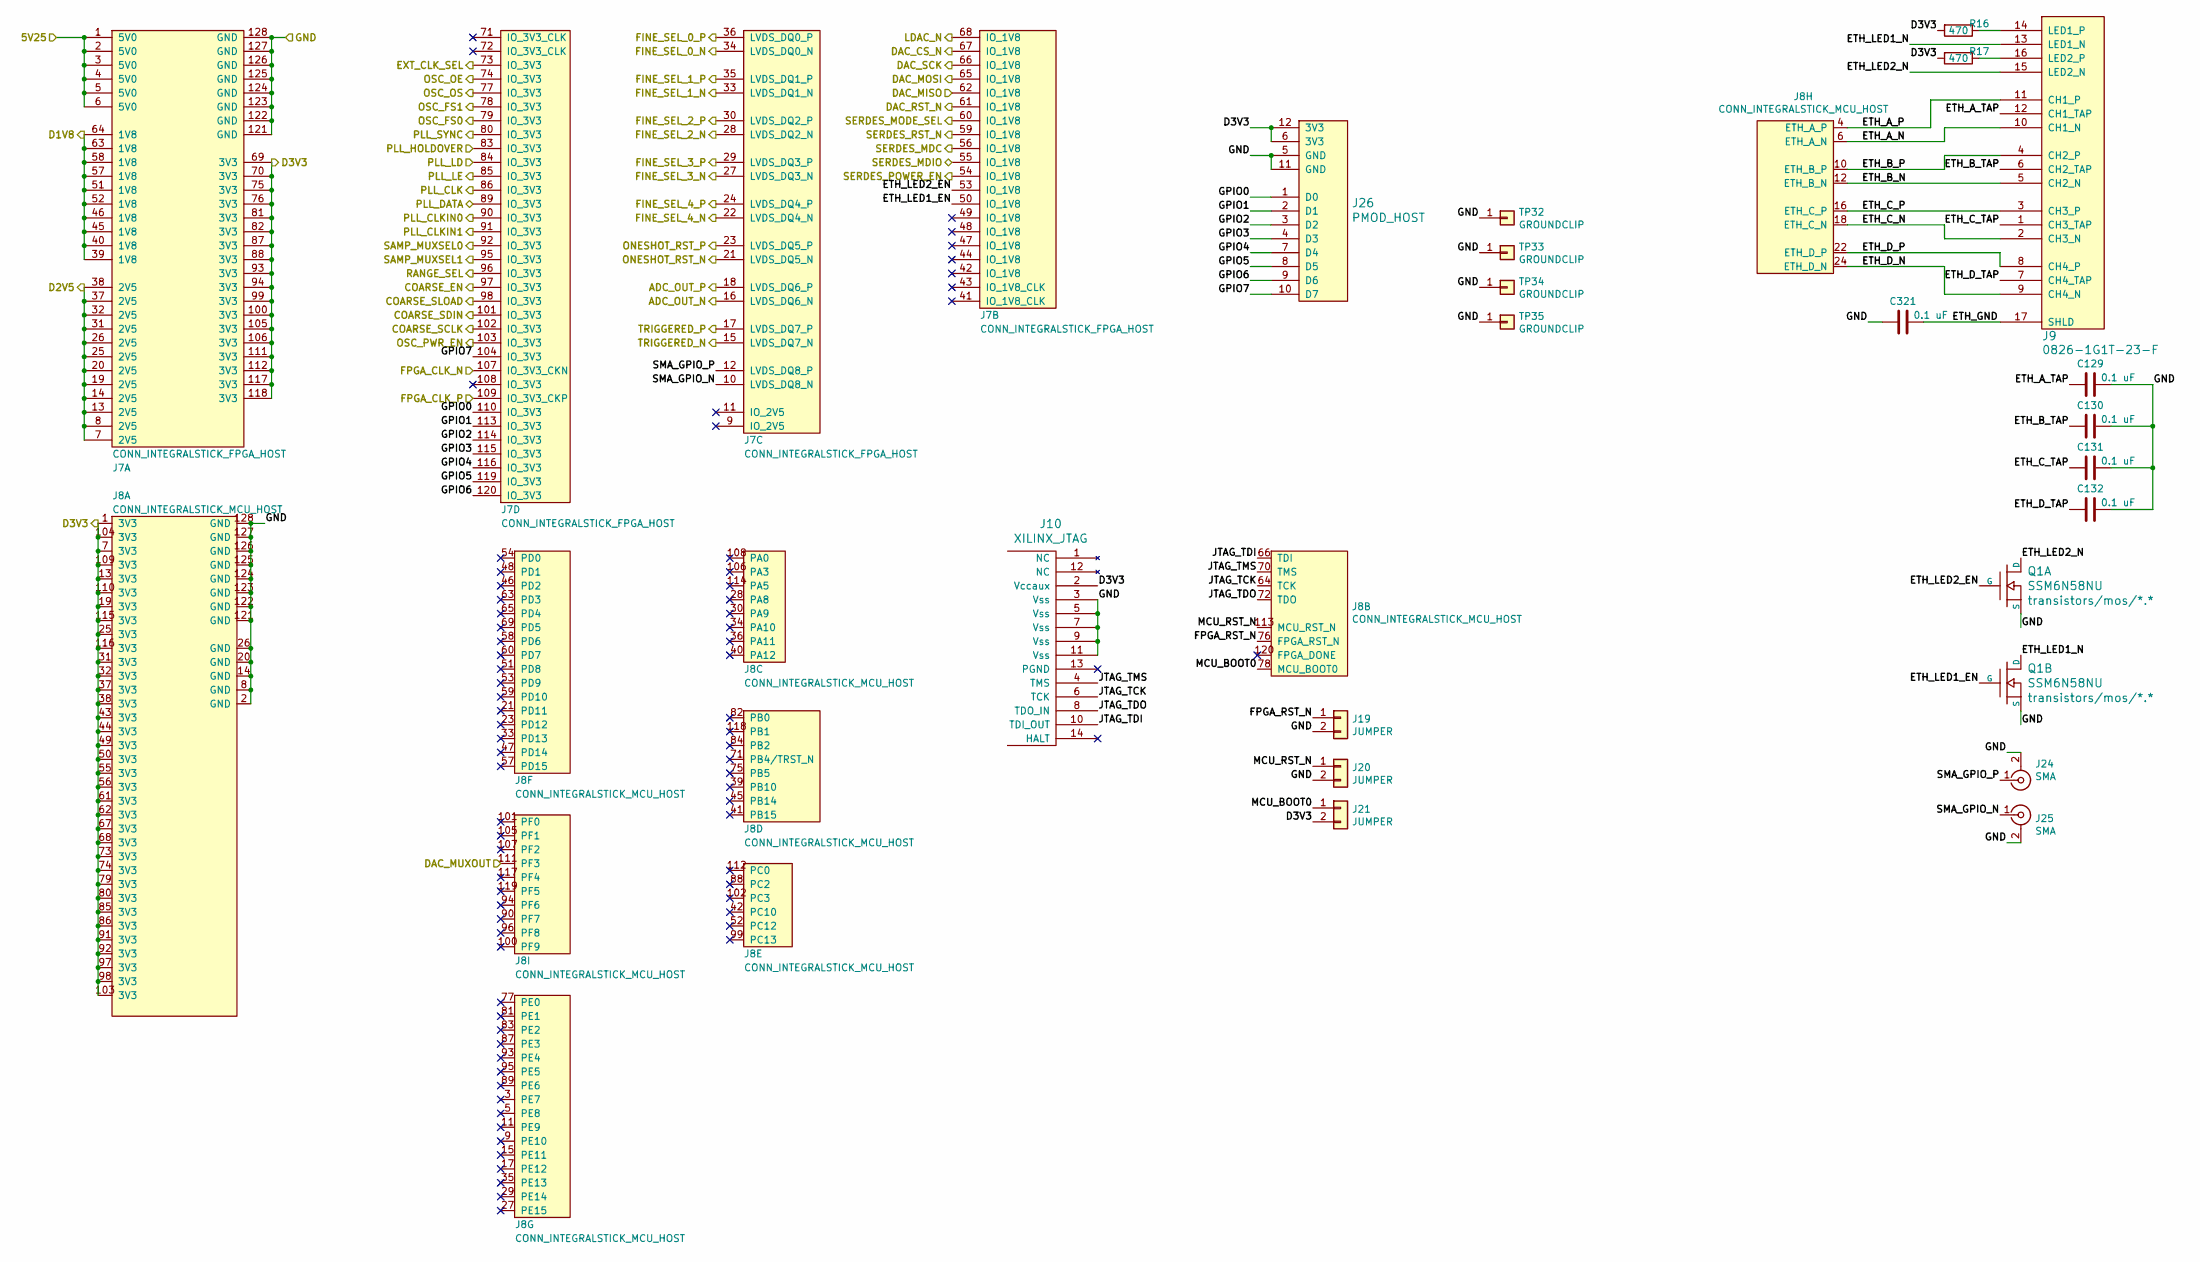
[picture p9: schematic som.sch, FREESAMPLE Oscilloscope]

Parts:
C129, C130, C131, C132, C321: 0.1 uF; EIA_0402_CAP_NOSILK
J7: CONN_INTEGRALSTICK_FPGA_HOST; CONN_SAMTEC_QSH-060-01-L-D-A
J8: CONN_INTEGRALSTICK_MCU_HOST; CONN_SAMTEC_QSH-060-01-L-D-A
J9: 0826-1G1T-23-F; CONN_BELFUSE_0826_1G1T_23_F
J10: XILINX_JTAG; XILINX_JTAG_PTH_MOLEX_0878311420
J19, J20, J21: JUMPER; CONN_HEADER_2.54MM_1x2
J24, J25: SMA; CONN_SMA_EDGE_SAMTEC_SMA_J_P_H_ST_EM1
J26: PMOD_HOST; CONN_HEADER_2.54MM_2x6_RA_PMOD_HOST
Q1: SSM6N58NU; DFN_6_0.65MM_2x2MM_GDS
R16, R17: 470; EIA_0402_RES_NOSILK
TP32, TP33, TP34, TP35: GROUNDCLIP; TESTPOINT_SMT_KEYSTONE_5016

Connections:
/5V25: J7.1 (5V0), J7.2 (5V0), J7.3 (5V0), J7.4 (5V0), J7.5 (5V0), J7.6 (5V0); also elsewhere on the board
/ADC_OUT_N: J7.16 (LVDS_DQ6_N); also elsewhere on the board
/ADC_OUT_P: J7.18 (LVDS_DQ6_P); also elsewhere on the board
/COARSE_EN: J7.97 (IO_3V3); also elsewhere on the board
/COARSE_SCLK: J7.102 (IO_3V3); also elsewhere on the board
/COARSE_SDIN: J7.101 (IO_3V3); also elsewhere on the board
/COARSE_SLOAD: J7.98 (IO_3V3); also elsewhere on the board
/D3V3: J7.69 (3V3), J7.70 (3V3), J7.75 (3V3), J7.76 (3V3), J7.81 (3V3), J7.82 (3V3), J7.87 (3V3), J7.88 (3V3), J7.93 (3V3), J7.94 (3V3), J7.99 (3V3), J7.100 (3V3), J7.105 (3V3), J7.106 (3V3), J7.111 (3V3), J7.112 (3V3), J7.117 (3V3), J7.118 (3V3), J8.1 (3V3), J8.7 (3V3), J8.13 (3V3), J8.19 (3V3), J8.25 (3V3), J8.31 (3V3), J8.32 (3V3), J8.37 (3V3), J8.38 (3V3), J8.43 (3V3), J8.44 (3V3), J8.49 (3V3), J8.50 (3V3), J8.55 (3V3), J8.56 (3V3), J8.61 (3V3), J8.62 (3V3), J8.67 (3V3), J8.68 (3V3), J8.73 (3V3), J8.74 (3V3), J8.79 (3V3), J8.80 (3V3), J8.85 (3V3), J8.86 (3V3), J8.91 (3V3), J8.92 (3V3), J8.97 (3V3), J8.98 (3V3), J8.103 (3V3), J8.104 (3V3), J8.109 (3V3), J8.110 (3V3), J8.115 (3V3), J8.116 (3V3), J10.2 (Vccaux), J21.2, J26.6 (3V3), J26.12 (3V3), R16.2, R17.2; also elsewhere on the board
/DAC_CS_N: J7.67 (IO_1V8); also elsewhere on the board
/DAC_MISO: J7.62 (IO_1V8); also elsewhere on the board
/DAC_MOSI: J7.65 (IO_1V8); also elsewhere on the board
/DAC_MUXOUT: J8.111 (PF3); also elsewhere on the board
/DAC_RST_N: J7.61 (IO_1V8); also elsewhere on the board
/DAC_SCK: J7.66 (IO_1V8); also elsewhere on the board
/EXT_CLK_SEL: J7.73 (IO_3V3); also elsewhere on the board
/FINE_SEL0_N: J7.34 (LVDS_DQ0_N); also elsewhere on the board
/FINE_SEL0_P: J7.36 (LVDS_DQ0_P); also elsewhere on the board
/FINE_SEL1_N: J7.33 (LVDS_DQ1_N); also elsewhere on the board
/FINE_SEL1_P: J7.35 (LVDS_DQ1_P); also elsewhere on the board
/FINE_SEL2_N: J7.28 (LVDS_DQ2_N); also elsewhere on the board
/FINE_SEL2_P: J7.30 (LVDS_DQ2_P); also elsewhere on the board
/FINE_SEL3_N: J7.27 (LVDS_DQ3_N); also elsewhere on the board
/FINE_SEL3_P: J7.29 (LVDS_DQ3_P); also elsewhere on the board
/FINE_SEL4_N: J7.22 (LVDS_DQ4_N); also elsewhere on the board
/FINE_SEL4_P: J7.24 (LVDS_DQ4_P); also elsewhere on the board
/FPGACLK_N: J7.107 (IO_3V3_CKN); also elsewhere on the board
/FPGACLK_P: J7.109 (IO_3V3_CKP); also elsewhere on the board
/GND: C129.1, C130.1, C131.1, C132.1, C321.2, J7.121 (GND), J7.122 (GND), J7.123 (GND), J7.124 (GND), J7.125 (GND), J7.126 (GND), J7.127 (GND), J7.128 (GND), J8.2 (GND), J8.8 (GND), J8.14 (GND), J8.20 (GND), J8.26 (GND), J8.121 (GND), J8.122 (GND), J8.123 (GND), J8.124 (GND), J8.125 (GND), J8.126 (GND), J8.127 (GND), J8.128 (GND), J10.3 (Vss), J10.5 (Vss), J10.7 (Vss), J10.9 (Vss), J10.11 (Vss), J19.2, J20.2, J24.2 (Ext), J25.2 (Ext), J26.5 (GND), J26.11 (GND), Q1.S1 (S), Q1.S2 (S), TP32.1, TP33.1, TP34.1, TP35.1; also elsewhere on the board
/LDAC_N: J7.68 (IO_1V8); also elsewhere on the board
/ONESHOT_RST_N: J7.21 (LVDS_DQ5_N); also elsewhere on the board
/ONESHOT_RST_P: J7.23 (LVDS_DQ5_P); also elsewhere on the board
/OSC_FS0: J7.79 (IO_3V3); also elsewhere on the board
/OSC_FS1: J7.78 (IO_3V3); also elsewhere on the board
/OSC_OE: J7.74 (IO_3V3); also elsewhere on the board
/OSC_OS: J7.77 (IO_3V3); also elsewhere on the board
/OSC_PWR_EN: J7.103 (IO_3V3); also elsewhere on the board
/PLL_CLK: J7.86 (IO_3V3); also elsewhere on the board
/PLL_CLKIN0: J7.90 (IO_3V3); also elsewhere on the board
/PLL_CLKIN1: J7.91 (IO_3V3); also elsewhere on the board
/PLL_DATA: J7.89 (IO_3V3); also elsewhere on the board
/PLL_HOLDOVER: J7.83 (IO_3V3); also elsewhere on the board
/PLL_LD: J7.84 (IO_3V3); also elsewhere on the board
/PLL_LE: J7.85 (IO_3V3); also elsewhere on the board
/PLL_SYNC: J7.80 (IO_3V3); also elsewhere on the board
/RANGE_SEL: J7.96 (IO_3V3); also elsewhere on the board
/SAMP_MUXSEL0: J7.92 (IO_3V3); also elsewhere on the board
/SAMP_MUXSEL1: J7.95 (IO_3V3); also elsewhere on the board
/SERDES_MDC: J7.56 (IO_1V8); also elsewhere on the board
/SERDES_MDIO: J7.55 (IO_1V8); also elsewhere on the board
/SERDES_MODE_SEL: J7.60 (IO_1V8); also elsewhere on the board
/SERDES_POWER_EN: J7.54 (IO_1V8); also elsewhere on the board
/SERDES_RST_N: J7.59 (IO_1V8); also elsewhere on the board
/SoM connectors/D1V8: J7.39 (1V8), J7.40 (1V8), J7.45 (1V8), J7.46 (1V8), J7.51 (1V8), J7.52 (1V8), J7.57 (1V8), J7.58 (1V8), J7.63 (1V8), J7.64 (1V8)
/SoM connectors/D2V5: J7.7 (2V5), J7.8 (2V5), J7.13 (2V5), J7.14 (2V5), J7.19 (2V5), J7.20 (2V5), J7.25 (2V5), J7.26 (2V5), J7.31 (2V5), J7.32 (2V5), J7.37 (2V5), J7.38 (2V5)
/SoM connectors/ETH_A_N: J8.6 (ETH_A_N), J9.10 (CH1_N)
/SoM connectors/ETH_A_P: J8.4 (ETH_A_P), J9.11 (CH1_P)
/SoM connectors/ETH_A_TAP: C129.2, J9.12 (CH1_TAP)
/SoM connectors/ETH_B_N: J8.12 (ETH_B_N), J9.5 (CH2_N)
/SoM connectors/ETH_B_P: J8.10 (ETH_B_P), J9.4 (CH2_P)
/SoM connectors/ETH_B_TAP: C130.2, J9.6 (CH2_TAP)
/SoM connectors/ETH_C_N: J8.18 (ETH_C_N), J9.2 (CH3_N)
/SoM connectors/ETH_C_P: J8.16 (ETH_C_P), J9.3 (CH3_P)
/SoM connectors/ETH_C_TAP: C131.2, J9.1 (CH3_TAP)
/SoM connectors/ETH_D_N: J8.24 (ETH_D_N), J9.9 (CH4_N)
/SoM connectors/ETH_D_P: J8.22 (ETH_D_P), J9.8 (CH4_P)
/SoM connectors/ETH_D_TAP: C132.2, J9.7 (CH4_TAP)
/SoM connectors/ETH_GND: C321.1, J9.17 (SHLD)
/SoM connectors/ETH_LED1_EN: J7.50 (IO_1V8), Q1.G2 (G)
/SoM connectors/ETH_LED1_N: J9.13 (LED1_N), Q1.D2 (D)
/SoM connectors/ETH_LED2_EN: J7.53 (IO_1V8), Q1.G1 (G)
/SoM connectors/ETH_LED2_N: J9.15 (LED2_N), Q1.D1 (D)
/SoM connectors/FPGA_RST_N: J8.76 (FPGA_RST_N), J19.1
/SoM connectors/GPIO0: J7.110 (IO_3V3), J26.1 (D0)
/SoM connectors/GPIO1: J7.113 (IO_3V3), J26.2 (D1)
/SoM connectors/GPIO2: J7.114 (IO_3V3), J26.3 (D2)
/SoM connectors/GPIO3: J7.115 (IO_3V3), J26.4 (D3)
/SoM connectors/GPIO4: J7.116 (IO_3V3), J26.7 (D4)
/SoM connectors/GPIO5: J7.119 (IO_3V3), J26.8 (D5)
/SoM connectors/GPIO6: J7.120 (IO_3V3), J26.9 (D6)
/SoM connectors/GPIO7: J7.104 (IO_3V3), J26.10 (D7)
/SoM connectors/JTAG_TCK: J8.64 (TCK), J10.6 (TCK)
/SoM connectors/JTAG_TDI: J8.66 (TDI), J10.10 (TDI_OUT)
/SoM connectors/JTAG_TDO: J8.72 (TDO), J10.8 (TDO_IN)
/SoM connectors/JTAG_TMS: J8.70 (TMS), J10.4 (TMS)
/SoM connectors/MCU_BOOT0: J8.78 (MCU_BOOT0), J21.1
/SoM connectors/MCU_RST_N: J8.113 (MCU_RST_N), J20.1
/SoM connectors/SMA_GPIO_N: J7.10 (LVDS_DQ8_N), J25.1 (In)
/SoM connectors/SMA_GPIO_P: J7.12 (LVDS_DQ8_P), J24.1 (In)
/TRIGGERED_N: J7.15 (LVDS_DQ7_N); also elsewhere on the board
/TRIGGERED_P: J7.17 (LVDS_DQ7_P); also elsewhere on the board
unnamed: J9.14 (LED1_P), R16.1
unnamed: J9.16 (LED2_P), R17.1
