azonenberg/freesample/boards/freesample/freesample.kicad_pcb

## KiCad design boards/freesample/freesample.kicad_pcb (continued)

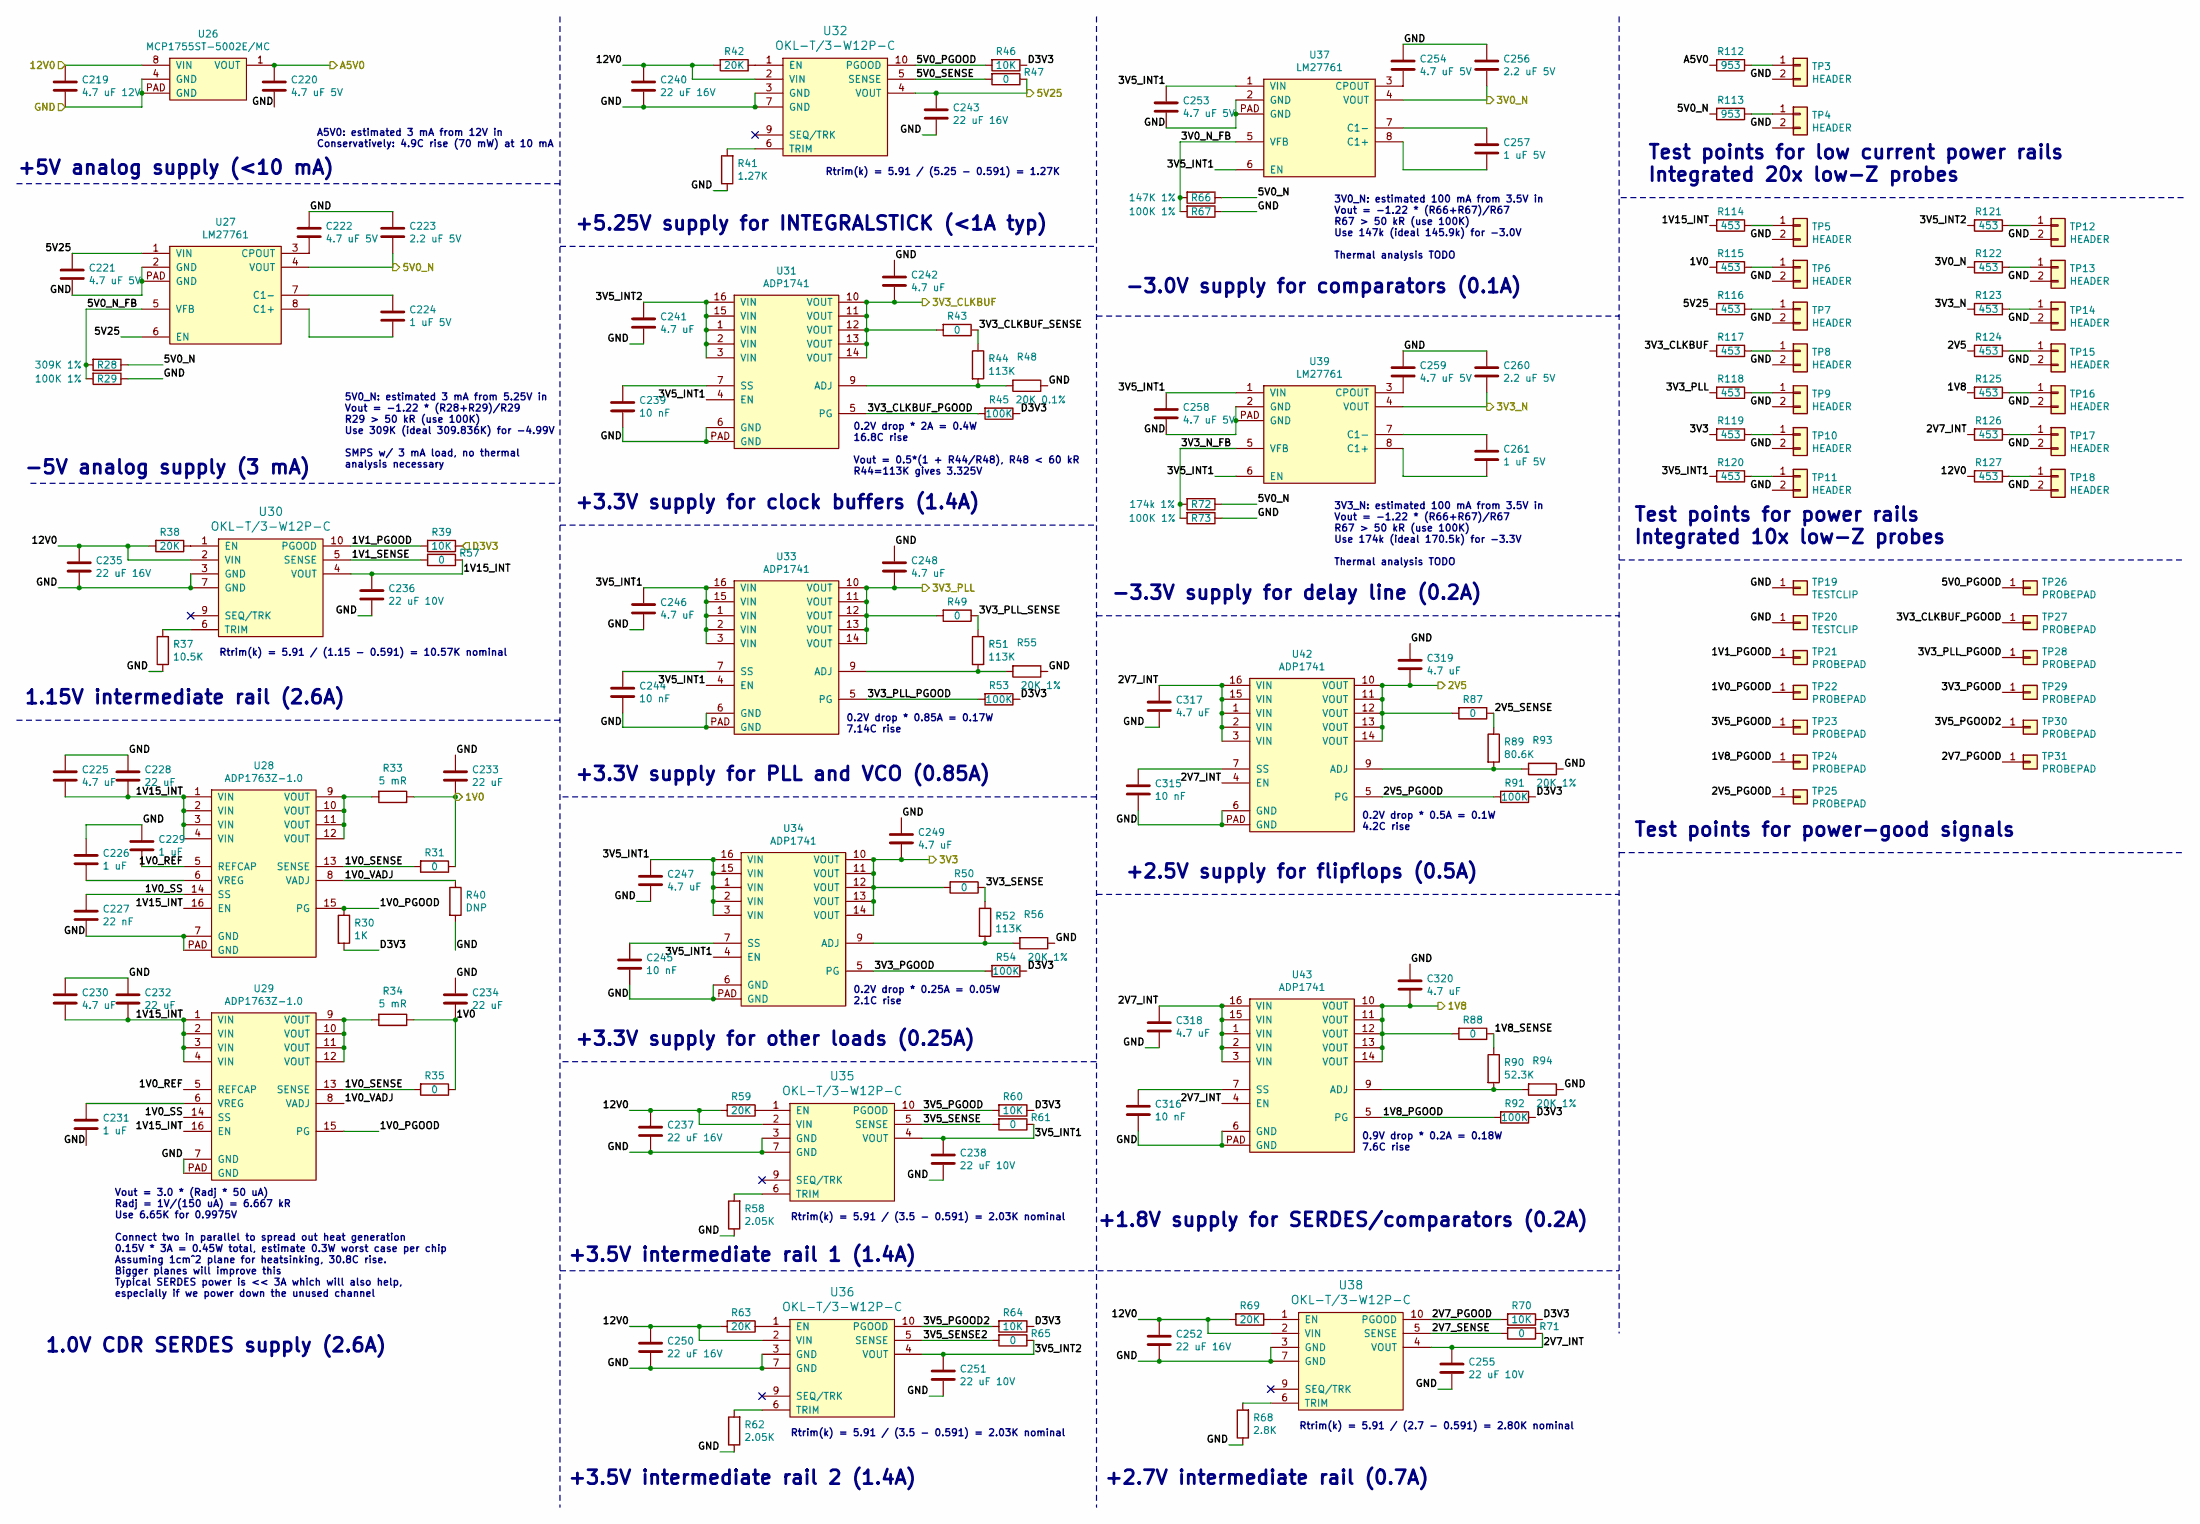
[picture p10: schematic psu.sch, FREESAMPLE Oscilloscope]

Parts:
C219: 4.7 uF 12V; EIA_1206_CAP_NOSILK
C220, C221, C222, C253, C254, C258, C259: 4.7 uF 5V; EIA_1206_CAP_NOSILK
C223, C256, C260: 2.2 uF 5V; EIA_0603_CAP_NOSILK
C224, C257, C261: 1 uF 5V; EIA_0603_CAP_NOSILK
C225, C230, C241, C242, C246, C247, C248, C249, C317, C318, C319, C320: 4.7 uF; EIA_0603_CAP_NOSILK
C226, C229: 1 uF; EIA_0603_CAP_NOSILK
C227: 22 nF; EIA_0402_CAP_NOSILK
C228, C232, C233, C234: 22 uF; EIA_0805_CAP_NOSILK
C231: 1 uF; EIA_0402_CAP_NOSILK
C235, C237, C240, C243, C250, C252: 22 uF 16V; EIA_1812_CAP_NOSILK
C236, C238, C251, C255: 22 uF 10V; EIA_1210_CAP_NOSILK
C239, C244, C245, C315, C316: 10 nF; EIA_0402_CAP_NOSILK
R28: 309K 1%; EIA_0402_RES_NOSILK
R29, R67, R73: 100K 1%; EIA_0402_RES_NOSILK
R30: 1K; EIA_0402_RES_NOSILK
R31, R35, R43, R47, R49, R50, R57, R61, R65, R71, R87, R88: 0; EIA_0402_RES_NOSILK
R33, R34: 5 mR; EIA_0603_RES_NOSILK
R37: 10.5K; EIA_0402_RES_NOSILK
R38, R42, R59, R63, R69: 20K; EIA_0402_RES_NOSILK
R39, R46, R60, R64, R70: 10K; EIA_0402_RES_NOSILK
R40: DNP; EIA_0402_RES_NOSILK
R41: 1.27K; EIA_0402_RES_NOSILK
R44, R51, R52: 113K; EIA_0402_RES_NOSILK
R45, R53, R54, R91, R92: 100K; EIA_0402_RES_NOSILK
R48: 20K 0.1%; EIA_0402_RES_NOSILK
R55, R56, R93, R94: 20K 1%; EIA_0402_RES_NOSILK
R58, R62: 2.05K; EIA_0402_RES_NOSILK
R66: 147K 1%; EIA_0402_RES_NOSILK
R68: 2.8K; EIA_0402_RES_NOSILK
R72: 174k 1%; EIA_0402_RES_NOSILK
R89: 80.6K; EIA_0402_RES_NOSILK
R90: 52.3K; EIA_0402_RES_NOSILK
R112, R113: 953; EIA_0402_RES_NOSILK
R114, R115, R116, R117, R118, R119, R120, R121, R122, R123, R124, R125, R126, R127: 453; EIA_0402_RES_NOSILK
TP3, TP4, TP5, TP6, TP7, TP8, TP9, TP10, TP11, TP12, TP13, TP14, TP15, TP16, TP17, TP18: HEADER; CONN_HEADER_2.54MM_1x2
TP19, TP20: TESTCLIP; TESTPOINT_SMT_KEYSTONE_5016
TP21, TP22, TP23, TP24, TP25, TP26, TP27, TP28, TP29, TP30, TP31: PROBEPAD; TESTPOINT_SMT_0.5MM
U26: MCP1755ST-5002E/MC; DFN_8_0.5MM_3x3MM
U27, U37, U39: LM27761; DFN_8_0.5MM_2x2MM
U28, U29: ADP1763Z-1.0; QFN_16_0.5MM_3x3MM
U30, U32, U35, U36, U38: OKL-T/3-W12P-C; MODULE_MURATA_OKL-T3-W12
U31, U33, U34, U42, U43: ADP1741; QFN_16_0.65MM_4x4MM

Connections:
/1V0: C233.1, C234.1, R31.1, R33.1, R34.1, R35.1, R115.2; also elsewhere on the board
/1V8: C320.2, R88.2, R125.2, U43.10 (VOUT), U43.11 (VOUT), U43.12 (VOUT), U43.13 (VOUT), U43.14 (VOUT); also elsewhere on the board
/2V5: C319.2, R87.2, R124.2, U42.10 (VOUT), U42.11 (VOUT), U42.12 (VOUT), U42.13 (VOUT), U42.14 (VOUT); also elsewhere on the board
/3V0_N: C256.2, R122.2, U37.4 (VOUT); also elsewhere on the board
/3V3: C249.2, R50.2, R119.2, U34.10 (VOUT), U34.11 (VOUT), U34.12 (VOUT), U34.13 (VOUT), U34.14 (VOUT); also elsewhere on the board
/3V3_CLKBUF: C242.2, R43.2, R117.2, U31.10 (VOUT), U31.11 (VOUT), U31.12 (VOUT), U31.13 (VOUT), U31.14 (VOUT); also elsewhere on the board
/3V3_N: C260.2, R123.2, U39.4 (VOUT); also elsewhere on the board
/3V3_PLL: C248.2, R49.2, R118.2, U33.10 (VOUT), U33.11 (VOUT), U33.12 (VOUT), U33.13 (VOUT), U33.14 (VOUT); also elsewhere on the board
/5V0_N: C223.2, R28.1, R66.1, R72.1, R113.2, U27.4 (VOUT); also elsewhere on the board
/5V25: C221.1, C243.1, R47.1, R116.2, U27.1 (VIN), U27.6 (EN), U32.4 (VOUT); also elsewhere on the board
/12V0: C219.1, C235.1, C237.1, C240.1, C250.1, C252.1, R38.2, R42.2, R59.2, R63.2, R69.2, R127.2, U26.8 (VIN), U30.2 (VIN), U32.2 (VIN), U35.2 (VIN), U36.2 (VIN), U38.2 (VIN); also elsewhere on the board
/A5V0: C220.1, R112.2, U26.1 (VOUT); also elsewhere on the board
/D3V3: R30.2, R39.1, R45.1, R46.1, R53.1, R54.1, R60.1, R64.1, R70.1, R91.1, R92.1; also elsewhere on the board
/GND: C219.2, C220.2, C221.2, C222.1, C223.1, C225.2, C226.2, C227.1, C228.2, C229.2, C230.2, C231.1, C232.2, C233.2, C234.2, C235.2, C236.2, C237.2, C238.2, C239.2, C240.2, C241.2, C242.1, C243.2, C244.2, C245.2, C246.2, C247.2, C248.1, C249.1, C250.2, C251.2, C252.2, C253.2, C254.1, C255.2, C256.1, C258.2, C259.1, C260.1, C315.2, C316.2, C317.2, C318.2, C319.1, C320.1, R29.1, R37.1, R40.2, R41.1, R48.1, R55.1, R56.1, R58.1, R62.1, R67.1, R68.1, R73.1, R93.1, R94.1, TP3.2, TP4.2, TP5.2, TP6.2, TP7.2, TP8.2, TP9.2, TP10.2, TP11.2, TP12.2, TP13.2, TP14.2, TP15.2, TP16.2, TP17.2, TP18.2, TP19.1, TP20.1, U26.4 (GND), U26.PAD (GND), U27.2 (GND), U27.PAD (GND), U28.7 (GND), U28.PAD (GND), U29.7 (GND), U29.PAD (GND), U30.3 (GND), U30.7 (GND), U31.6 (GND), U31.PAD (GND), U32.3 (GND), U32.7 (GND), U33.6 (GND), U33.PAD (GND), U34.6 (GND), U34.PAD (GND), U35.3 (GND), U35.7 (GND), U36.3 (GND), U36.7 (GND), U37.2 (GND), U37.PAD (GND), U38.3 (GND), U38.7 (GND), U39.2 (GND), U39.PAD (GND), U42.6 (GND), U42.PAD (GND), U43.6 (GND), U43.PAD (GND); also elsewhere on the board
/Power supply/1V0_PGOOD: R30.1, TP22.1, U28.15 (PG), U29.15 (PG)
/Power supply/1V0_REF: C229.1, U28.5 (REFCAP), U29.5 (REFCAP)
/Power supply/1V0_SENSE: R31.2, R35.2, U28.13 (SENSE), U29.13 (SENSE)
/Power supply/1V0_SS: C227.2, U28.14 (SS), U29.14 (SS)
/Power supply/1V0_VADJ: R40.1, U28.8 (VADJ), U29.8 (VADJ)
/Power supply/1V1_PGOOD: R39.2, TP21.1, U30.10 (PGOOD)
/Power supply/1V1_SENSE: R57.2, U30.5 (SENSE)
/Power supply/1V8_PGOOD: R92.2, TP24.1, U43.5 (PG)
/Power supply/1V8_SENSE: R88.1, R90.1
/Power supply/1V15_INT: C225.1, C228.1, C230.1, C232.1, C236.1, R57.1, R114.2, U28.1 (VIN), U28.2 (VIN), U28.3 (VIN), U28.4 (VIN), U28.16 (EN), U29.1 (VIN), U29.2 (VIN), U29.3 (VIN), U29.4 (VIN), U29.16 (EN), U30.4 (VOUT)
/Power supply/2V5_PGOOD: R91.2, TP25.1, U42.5 (PG)
/Power supply/2V5_SENSE: R87.1, R89.1
/Power supply/2V7_INT: C255.1, C317.1, C318.1, R71.1, R126.2, U38.4 (VOUT), U42.1 (VIN), U42.2 (VIN), U42.3 (VIN), U42.4 (EN), U42.15 (VIN), U42.16 (VIN), U43.1 (VIN), U43.2 (VIN), U43.3 (VIN), U43.4 (EN), U43.15 (VIN), U43.16 (VIN)
/Power supply/2V7_PGOOD: R70.2, TP31.1, U38.10 (PGOOD)
/Power supply/2V7_SENSE: R71.2, U38.5 (SENSE)
/Power supply/3V0_N_FB: R66.2, R67.2, U37.5 (VFB)
/Power supply/3V3_CLKBUF_PGOOD: R45.2, TP27.1, U31.5 (PG)
/Power supply/3V3_CLKBUF_SENSE: R43.1, R44.1
/Power supply/3V3_N_FB: R72.2, R73.2, U39.5 (VFB)
/Power supply/3V3_PGOOD: R54.2, TP29.1, U34.5 (PG)
/Power supply/3V3_PLL_PGOOD: R53.2, TP28.1, U33.5 (PG)
/Power supply/3V3_PLL_SENSE: R49.1, R51.1
/Power supply/3V3_SENSE: R50.1, R52.1
/Power supply/3V5_INT1: C238.1, C246.1, C247.1, C253.1, C258.1, R61.1, R120.2, U31.4 (EN), U33.1 (VIN), U33.2 (VIN), U33.3 (VIN), U33.4 (EN), U33.15 (VIN), U33.16 (VIN), U34.1 (VIN), U34.2 (VIN), U34.3 (VIN), U34.4 (EN), U34.15 (VIN), U34.16 (VIN), U35.4 (VOUT), U37.1 (VIN), U37.6 (EN), U39.1 (VIN), U39.6 (EN)
/Power supply/3V5_INT2: C241.1, C251.1, R65.1, R121.2, U31.1 (VIN), U31.2 (VIN), U31.3 (VIN), U31.15 (VIN), U31.16 (VIN), U36.4 (VOUT)
/Power supply/3V5_PGOOD: R60.2, TP23.1, U35.10 (PGOOD)
/Power supply/3V5_PGOOD2: R64.2, TP30.1, U36.10 (PGOOD)
/Power supply/3V5_SENSE: R61.2, U35.5 (SENSE)
/Power supply/3V5_SENSE2: R65.2, U36.5 (SENSE)
/Power supply/5V0_N_FB: R28.2, R29.2, U27.5 (VFB)
/Power supply/5V0_PGOOD: R46.2, TP26.1, U32.10 (PGOOD)
/Power supply/5V0_SENSE: R47.2, U32.5 (SENSE)
unnamed: C222.2, U27.3 (CPOUT)
unnamed: C224.1, U27.7 (C1-)
unnamed: C224.2, U27.8 (C1+)
unnamed: C226.1, U28.6 (VREG)
unnamed: C231.2, U29.6 (VREG)
unnamed: C239.1, U31.7 (SS)
unnamed: C244.1, U33.7 (SS)
unnamed: C245.1, U34.7 (SS)
unnamed: C254.2, U37.3 (CPOUT)
unnamed: C257.1, U37.7 (C1-)
unnamed: C257.2, U37.8 (C1+)
unnamed: C259.2, U39.3 (CPOUT)
unnamed: C261.1, U39.7 (C1-)
unnamed: C261.2, U39.8 (C1+)
unnamed: C315.1, U42.7 (SS)
unnamed: C316.1, U43.7 (SS)
unnamed: R33.2, U28.9 (VOUT), U28.10 (VOUT), U28.11 (VOUT), U28.12 (VOUT)
unnamed: R34.2, U29.9 (VOUT), U29.10 (VOUT), U29.11 (VOUT), U29.12 (VOUT)
unnamed: R37.2, U30.6 (TRIM)
unnamed: R38.1, U30.1 (EN)
unnamed: R41.2, U32.6 (TRIM)
unnamed: R42.1, U32.1 (EN)
unnamed: R44.2, R48.2, U31.9 (ADJ)
unnamed: R51.2, R55.2, U33.9 (ADJ)
unnamed: R52.2, R56.2, U34.9 (ADJ)
unnamed: R58.2, U35.6 (TRIM)
unnamed: R59.1, U35.1 (EN)
unnamed: R62.2, U36.6 (TRIM)
unnamed: R63.1, U36.1 (EN)
unnamed: R68.2, U38.6 (TRIM)
unnamed: R69.1, U38.1 (EN)
unnamed: R89.2, R93.2, U42.9 (ADJ)
unnamed: R90.2, R94.2, U43.9 (ADJ)
unnamed: R112.1, TP3.1
unnamed: R113.1, TP4.1
unnamed: R114.1, TP5.1
unnamed: R115.1, TP6.1
unnamed: R116.1, TP7.1
unnamed: R117.1, TP8.1
unnamed: R118.1, TP9.1
unnamed: R119.1, TP10.1
unnamed: R120.1, TP11.1
unnamed: R121.1, TP12.1
unnamed: R122.1, TP13.1
unnamed: R123.1, TP14.1
unnamed: R124.1, TP15.1
unnamed: R125.1, TP16.1
unnamed: R126.1, TP17.1
unnamed: R127.1, TP18.1

Notes on the sheet:
A5V0: estimated 3 mA from 12V in Conservatively: 4.9C rise (70 mW) at 10 mA
5V0_N: estimated 3 mA from 5.25V in Vout = -1.22 * (R28+R29)/R29 R29 > 50 kR (use 100K) Use 309K (ideal 309.836K) for -4.99V SMPS w/ 3 mA load, no thermal analysis necessary
Vout = 3.0 * (Radj * 50 uA) Radj = 1V/(150 uA) = 6.667 kR Use 6.65K for 0.9975V Connect two in parallel to spread out heat generation 0.15V * 3A = 0.45W total, estimate 0.3W worst case per chip Assuming 1cm^2 plane for heatsinking, 30.8C rise. Bigger planes will improve this Typical SERDES power is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
-5V analog supply (3 mA)
+5V analog supply (<10 mA)
1.15V intermediate rail (2.6A)
1.0V CDR SERDES supply (2.6A)
+5.25V supply for INTEGRALSTICK (<1A typ)
+3.3V supply for clock buffers (1.4A)
+3.3V supply for PLL and VCO (0.85A)
+3.3V supply for other loads (0.25A)
+3.5V intermediate rail 1 (1.4A)
0.2V drop * 0.85A = 0.17W 7.14C rise
0.2V drop * 2A = 0.4W 16.8C rise Vout = 0.5*(1 + R44/R48), R48 < 60 kR R44=113K gives 3.325V
0.2V drop * 0.25A = 0.05W 2.1C rise
Rtrim(k) = 5.91 / (5.25 - 0.591) = 1.27K
Rtrim(k) = 5.91 / (3.5 - 0.591) = 2.03K nominal
Rtrim(k) = 5.91 / (1.15 - 0.591) = 10.57K nominal
+2.7V intermediate rail (0.7A)
Rtrim(k) = 5.91 / (2.7 - 0.591) = 2.80K nominal
+2.5V supply for flipflops (0.5A)
+1.8V supply for SERDES/comparators (0.2A)
-3.0V supply for comparators (0.1A)
-3.3V supply for delay line (0.2A)
+3.5V intermediate rail 2 (1.4A)
3V0_N: estimated 100 mA from 3.5V in Vout = -1.22 * (R66+R67)/R67 R67 > 50 kR (use 100K) Use 147k (ideal 145.9k) for -3.0V Thermal analysis TODO
3V3_N: estimated 100 mA from 3.5V in Vout = -1.22 * (R66+R67)/R67 R67 > 50 kR (use 100K) Use 174k (ideal 170.5k) for -3.3V Thermal analysis TODO
0.2V drop * 0.5A = 0.1W 4.2C rise
0.9V drop * 0.2A = 0.18W 7.6C rise
Test points for power rails Integrated 10x low-Z probes
Test points for low current power rails Integrated 20x low-Z probes
Test points for power-good signals

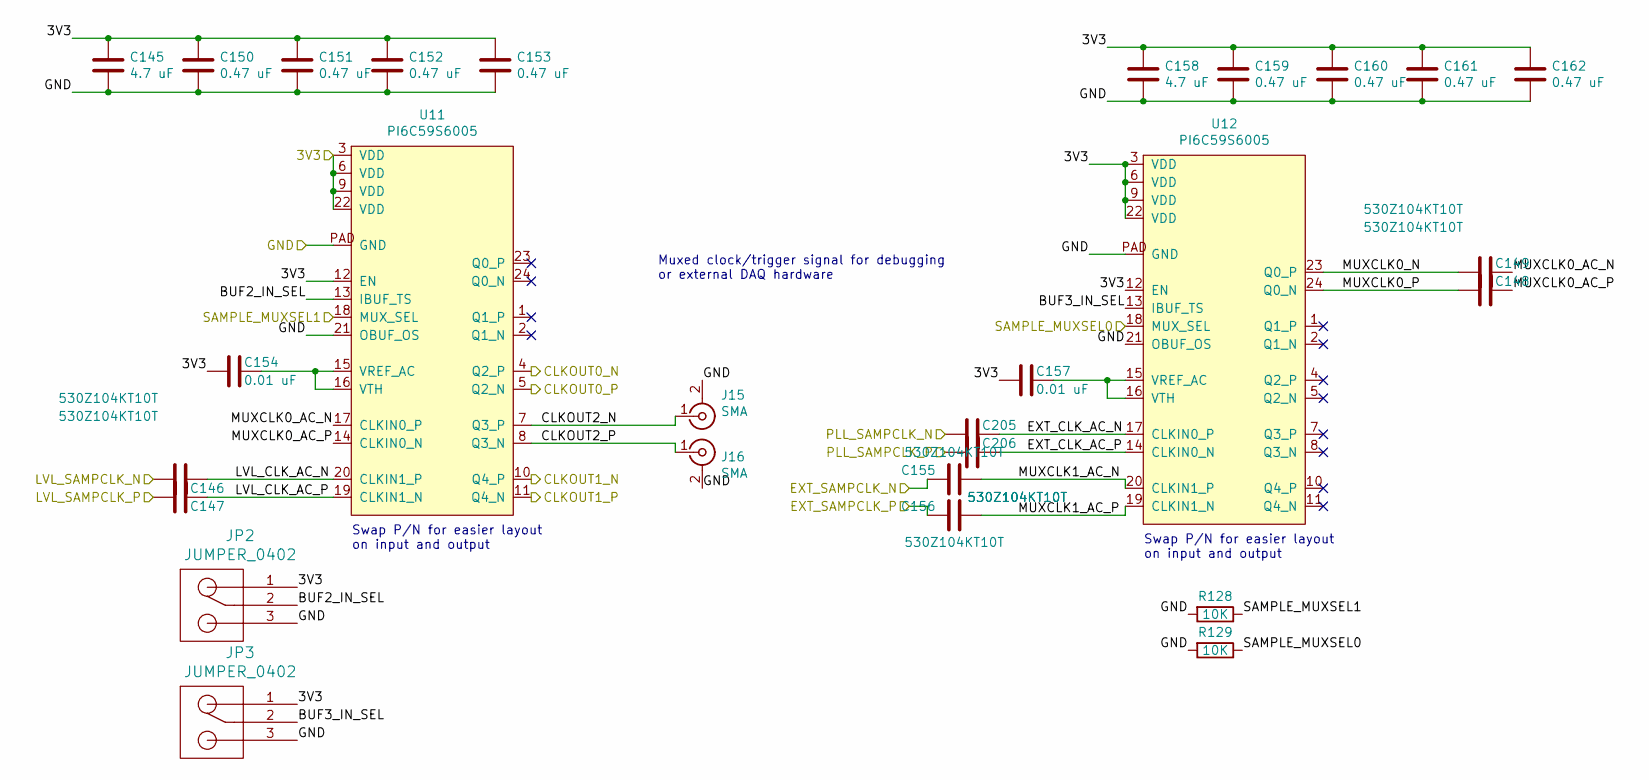
[picture p11: schematic sample-clockmux.sch, FREESAMPLE Oscilloscope]

Parts:
C145, C158: 4.7 uF; EIA_0603_CAP_NOSILK
C146, C147, C148, C149, C155, C156, C205, C206: 530Z104KT10T; EIA_0201_CAP_NOSILK
C150, C151, C152, C153, C159, C160, C161, C162: 0.47 uF; EIA_0402_CAP_NOSILK
C154, C157: 0.01 uF; EIA_0402_CAP_NOSILK
J15, J16: SMA; CONN_SMA_EDGE_SAMTEC_SMA_J_P_H_ST_EM1
JP2, JP3: JUMPER_0402; EIA_0402_JUMPER
R128, R129: 10K; EIA_0402_RES_NOSILK
U11, U12: PI6C59S6005; QFN_24_0.5MM_4x4MM

Connections:
/3V3_CLKBUF: C145.1, C150.1, C151.1, C152.1, C153.1, C154.2, C157.2, C158.1, C159.1, C160.1, C161.1, C162.1, JP2.1, JP3.1, U11.3 (VDD), U11.6 (VDD), U11.9 (VDD), U11.12 (EN), U11.22 (VDD), U12.3 (VDD), U12.6 (VDD), U12.9 (VDD), U12.12 (EN), U12.22 (VDD); also elsewhere on the board
/GND: C145.2, C150.2, C151.2, C152.2, C153.2, C158.2, C159.2, C160.2, C161.2, C162.2, J15.2 (Ext), J16.2 (Ext), JP2.3, JP3.3, R128.2, R129.2, U11.21 (OBUF_OS), U11.PAD (GND), U12.21 (OBUF_OS), U12.PAD (GND); also elsewhere on the board
/Level triggering/LTRIG_SAMPOUT_N: C147.2; also elsewhere on the board
/Level triggering/LTRIG_SAMPOUT_P: C146.2; also elsewhere on the board
/Phase control/CLKIN0_N: U11.4 (Q2_P); also elsewhere on the board
/Phase control/CLKIN0_P: U11.5 (Q2_N); also elsewhere on the board
/Phase control/CLKIN1_N: U11.10 (Q4_P); also elsewhere on the board
/Phase control/CLKIN1_P: U11.11 (Q4_N); also elsewhere on the board
/SAMP_MUXSEL0: R129.1, U12.18 (MUX_SEL); also elsewhere on the board
/SAMP_MUXSEL1: R128.1, U11.18 (MUX_SEL); also elsewhere on the board
/Sample clock muxing/BUF2_IN_SEL: JP2.2, U11.13 (IBUF_TS)
/Sample clock muxing/BUF3_IN_SEL: JP3.2, U12.13 (IBUF_TS)
/Sample clock muxing/CLKOUT2_N: J15.1 (In), U11.7 (Q3_P)
/Sample clock muxing/CLKOUT2_P: J16.1 (In), U11.8 (Q3_N)
/Sample clock muxing/EXT_CLK_AC_N: C205.1, U12.17 (CLKIN0_P)
/Sample clock muxing/EXT_CLK_AC_P: C206.1, U12.14 (CLKIN0_N)
/Sample clock muxing/EXT_SAMPCLK_N: C155.2; also elsewhere on the board
/Sample clock muxing/EXT_SAMPCLK_P: C156.2; also elsewhere on the board
/Sample clock muxing/LVL_CLK_AC_N: C147.1, U11.20 (CLKIN1_P)
/Sample clock muxing/LVL_CLK_AC_P: C146.1, U11.19 (CLKIN1_N)
/Sample clock muxing/MUXCLK0_AC_N: C149.1, U11.17 (CLKIN0_P)
/Sample clock muxing/MUXCLK0_AC_P: C148.1, U11.14 (CLKIN0_N)
/Sample clock muxing/MUXCLK0_N: C149.2, U12.23 (Q0_P)
/Sample clock muxing/MUXCLK0_P: C148.2, U12.24 (Q0_N)
/Sample clock muxing/MUXCLK1_AC_N: C155.1, U12.20 (CLKIN1_P)
/Sample clock muxing/MUXCLK1_AC_P: C156.1, U12.19 (CLKIN1_N)
/Sample clock muxing/PLL_SAMPCLK_N: C205.2; also elsewhere on the board
/Sample clock muxing/PLL_SAMPCLK_P: C206.2; also elsewhere on the board
unnamed: C154.1, U11.15 (VREF_AC), U11.16 (VTH)
unnamed: C157.1, U12.15 (VREF_AC), U12.16 (VTH)

Notes on the sheet:
Muxed clock/trigger signal for debugging or external DAQ hardware
Swap P/N for easier layout on input and output

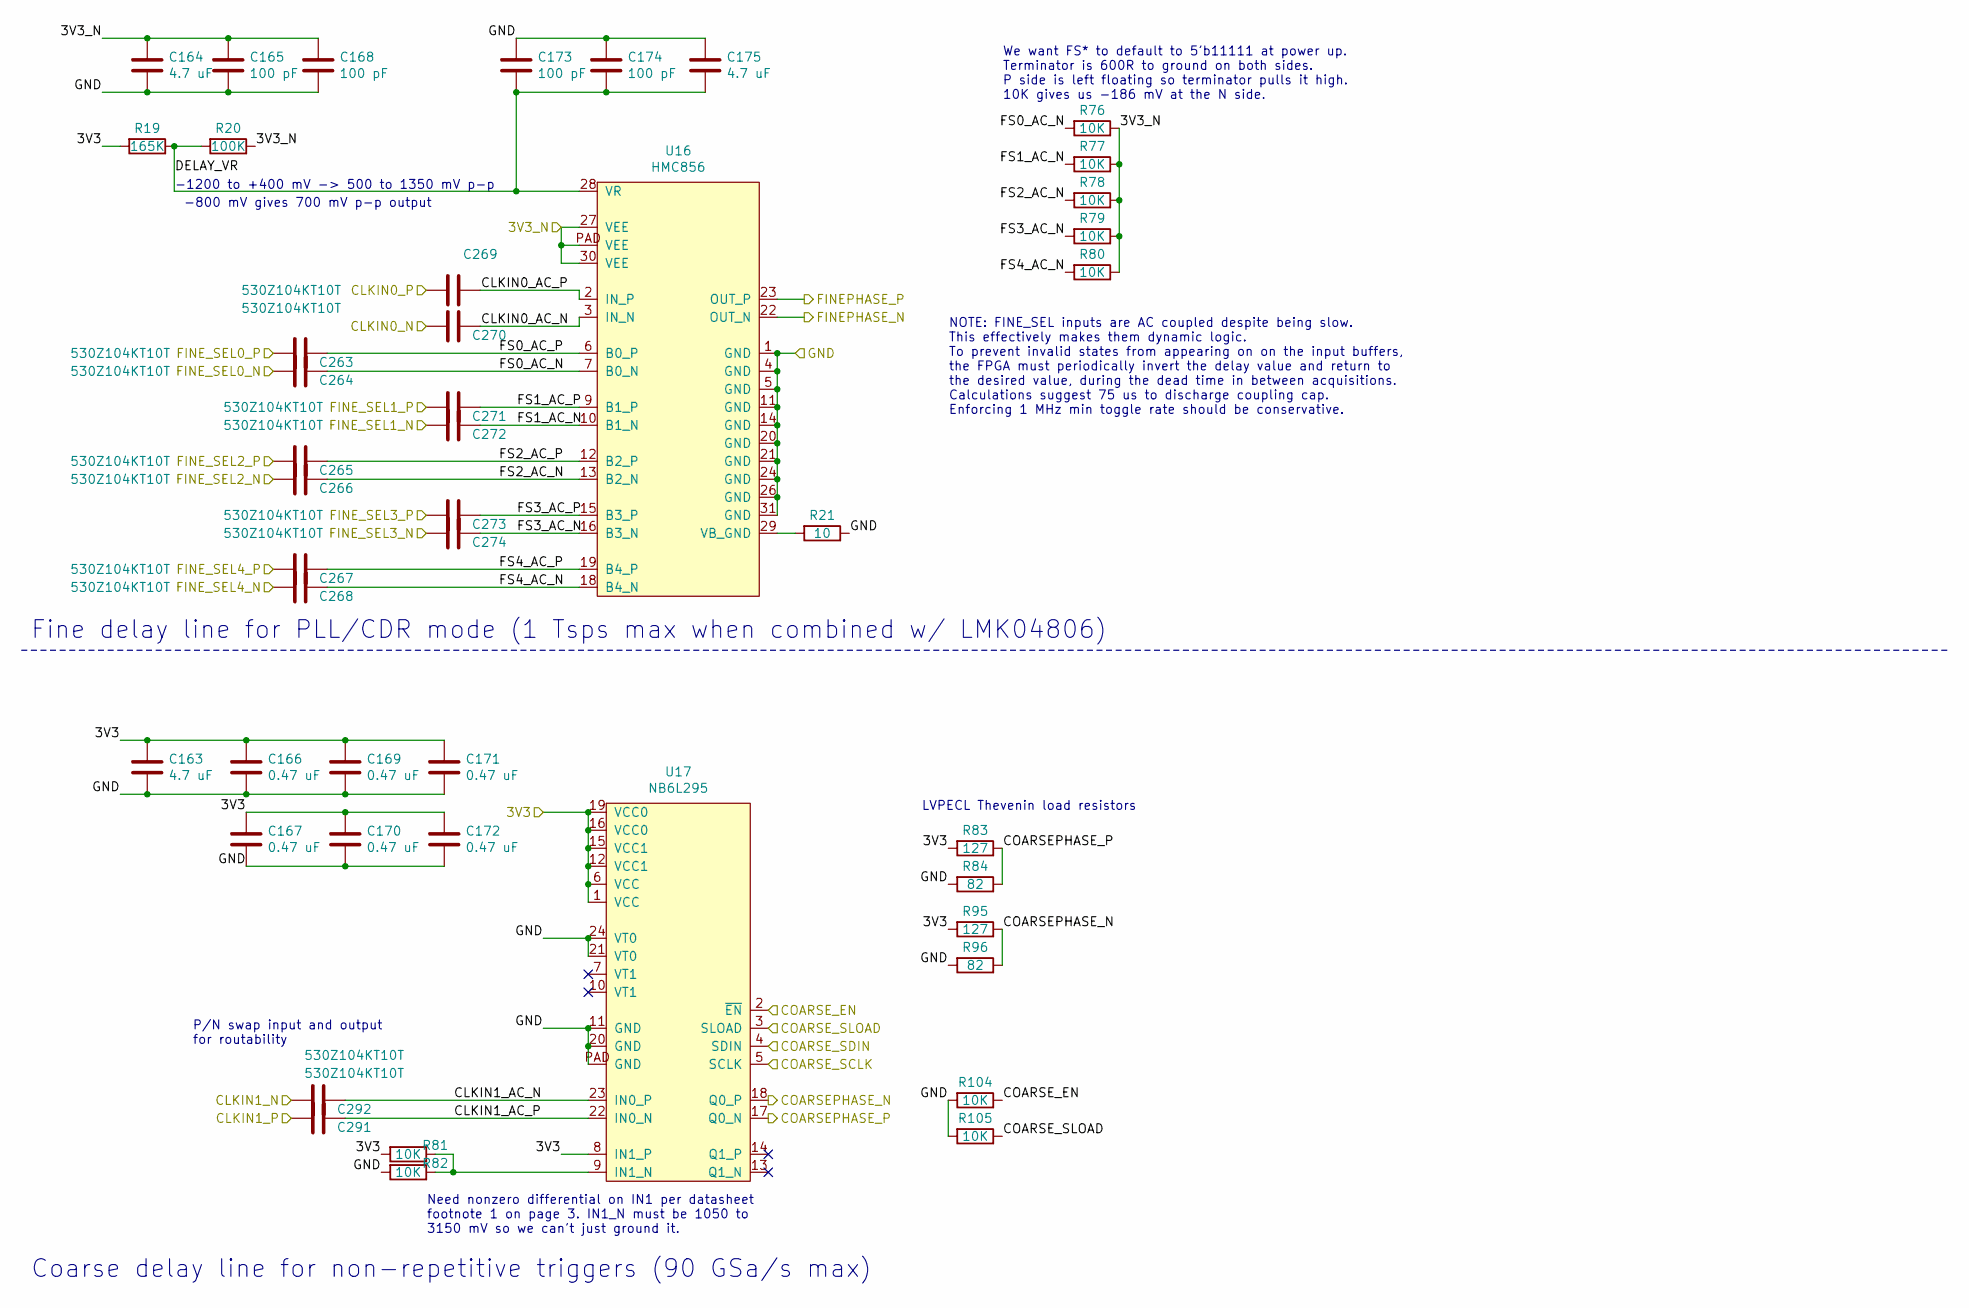
[picture p12: schematic phase-control.sch, FREESAMPLE Oscilloscope]

Parts:
C163, C164, C175: 4.7 uF; EIA_0603_CAP_NOSILK
C165, C168, C173, C174: 100 pF; EIA_0201_CAP_NOSILK
C166, C167, C169, C170, C171, C172: 0.47 uF; EIA_0402_CAP_NOSILK
C263, C264, C265, C266, C267, C268, C269, C270, C271, C272, C273, C274, C291, C292: 530Z104KT10T; EIA_0201_CAP_NOSILK
R19: 165K; EIA_0402_RES_NOSILK
R20: 100K; EIA_0402_RES_NOSILK
R21: 10; EIA_0402_RES_NOSILK
R76, R77, R78, R79, R80, R81, R82, R104, R105: 10K; EIA_0402_RES_NOSILK
R83, R95: 127; EIA_0402_RES_NOSILK
R84, R96: 82; EIA_0402_RES_NOSILK
U16: HMC856; QFN_32_0.5MM_5x5MM
U17: NB6L295; QFN_24_0.5MM_4x4MM

Connections:
/3V3: C163.1, C166.1, C167.1, C169.1, C170.1, C171.1, C172.1, R19.2, R81.2, R83.2, R95.2, U17.1 (VCC), U17.6 (VCC), U17.8 (IN1_P), U17.12 (VCC1), U17.15 (VCC1), U17.16 (VCC0), U17.19 (VCC0); also elsewhere on the board
/3V3_N: C164.1, C165.1, C168.1, R20.1, R76.1, R77.1, R78.1, R79.1, R80.1, U16.27 (VEE), U16.30 (VEE), U16.PAD (VEE); also elsewhere on the board
/COARSE_EN: R104.1, U17.2 (~EN); also elsewhere on the board
/COARSE_SCLK: U17.5 (SCLK); also elsewhere on the board
/COARSE_SDIN: U17.4 (SDIN); also elsewhere on the board
/COARSE_SLOAD: R105.1, U17.3 (SLOAD); also elsewhere on the board
/FINE_SEL0_N: C264.2; also elsewhere on the board
/FINE_SEL0_P: C263.2; also elsewhere on the board
/FINE_SEL1_N: C272.2; also elsewhere on the board
/FINE_SEL1_P: C271.2; also elsewhere on the board
/FINE_SEL2_N: C266.2; also elsewhere on the board
/FINE_SEL2_P: C265.2; also elsewhere on the board
/FINE_SEL3_N: C274.2; also elsewhere on the board
/FINE_SEL3_P: C273.2; also elsewhere on the board
/FINE_SEL4_N: C268.2; also elsewhere on the board
/FINE_SEL4_P: C267.2; also elsewhere on the board
/GND: C163.2, C164.2, C165.2, C166.2, C167.2, C168.2, C169.2, C170.2, C171.2, C172.2, C173.1, C174.1, C175.1, R21.1, R82.2, R84.2, R96.2, R104.2, R105.2, U16.1 (GND), U16.4 (GND), U16.5 (GND), U16.11 (GND), U16.14 (GND), U16.20 (GND), U16.21 (GND), U16.24 (GND), U16.26 (GND), U16.31 (GND), U17.11 (GND), U17.20 (GND), U17.21 (VT0), U17.24 (VT0), U17.PAD (GND); also elsewhere on the board
/Phase control/CLKIN0_AC_N: C270.1, U16.3 (IN_N)
/Phase control/CLKIN0_AC_P: C269.1, U16.2 (IN_P)
/Phase control/CLKIN0_N: C270.2; also elsewhere on the board
/Phase control/CLKIN0_P: C269.2; also elsewhere on the board
/Phase control/CLKIN1_AC_N: C292.1, U17.23 (IN0_P)
/Phase control/CLKIN1_AC_P: C291.1, U17.22 (IN0_N)
/Phase control/CLKIN1_N: C292.2; also elsewhere on the board
/Phase control/CLKIN1_P: C291.2; also elsewhere on the board
/Phase control/COARSEPHASE_N: R95.1, R96.1, U17.18 (Q0_P); also elsewhere on the board
/Phase control/COARSEPHASE_P: R83.1, R84.1, U17.17 (Q0_N); also elsewhere on the board
/Phase control/DELAY_VR: C173.2, C174.2, C175.2, R19.1, R20.2, U16.28 (VR)
/Phase control/FINEPHASE_N: U16.22 (OUT_N); also elsewhere on the board
/Phase control/FINEPHASE_P: U16.23 (OUT_P); also elsewhere on the board
/Phase control/FS0_AC_N: C264.1, R76.2, U16.7 (B0_N)
/Phase control/FS0_AC_P: C263.1, U16.6 (B0_P)
/Phase control/FS1_AC_N: C272.1, R77.2, U16.10 (B1_N)
/Phase control/FS1_AC_P: C271.1, U16.9 (B1_P)
/Phase control/FS2_AC_N: C266.1, R78.2, U16.13 (B2_N)
/Phase control/FS2_AC_P: C265.1, U16.12 (B2_P)
/Phase control/FS3_AC_N: C274.1, R79.2, U16.16 (B3_N)
/Phase control/FS3_AC_P: C273.1, U16.15 (B3_P)
/Phase control/FS4_AC_N: C268.1, R80.2, U16.18 (B4_N)
/Phase control/FS4_AC_P: C267.1, U16.19 (B4_P)
unnamed: R21.2, U16.29 (VB_GND)
unnamed: R81.1, R82.1, U17.9 (IN1_N)

Notes on the sheet:
-1200 to +400 mV -> 500 to 1350 mV p-p
-800 mV gives 700 mV p-p output
Need nonzero differential on IN1 per datasheet footnote 1 on page 3. IN1_N must be 1050 to 3150 mV so we can't just ground it.
Fine delay line for PLL/CDR mode (1 Tsps max when combined w/ LMK04806)
Coarse delay line for non-repetitive triggers (90 GSa/s max)
NOTE: FINE_SEL inputs are AC coupled despite being slow. This effectively makes them dynamic logic. To prevent invalid states from appearing on on the input buffers, the FPGA must periodically invert the delay value and return to the desired value, during the dead time in between acquisitions. Calc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
We want FS* to default to 5'b11111 at power up. Terminator is 600R to ground on both sides. P side is left floating so terminator pulls it high. 10K gives us -186 mV at the N side.
LVPECL Thevenin load resistors
P/N swap input and output for routability

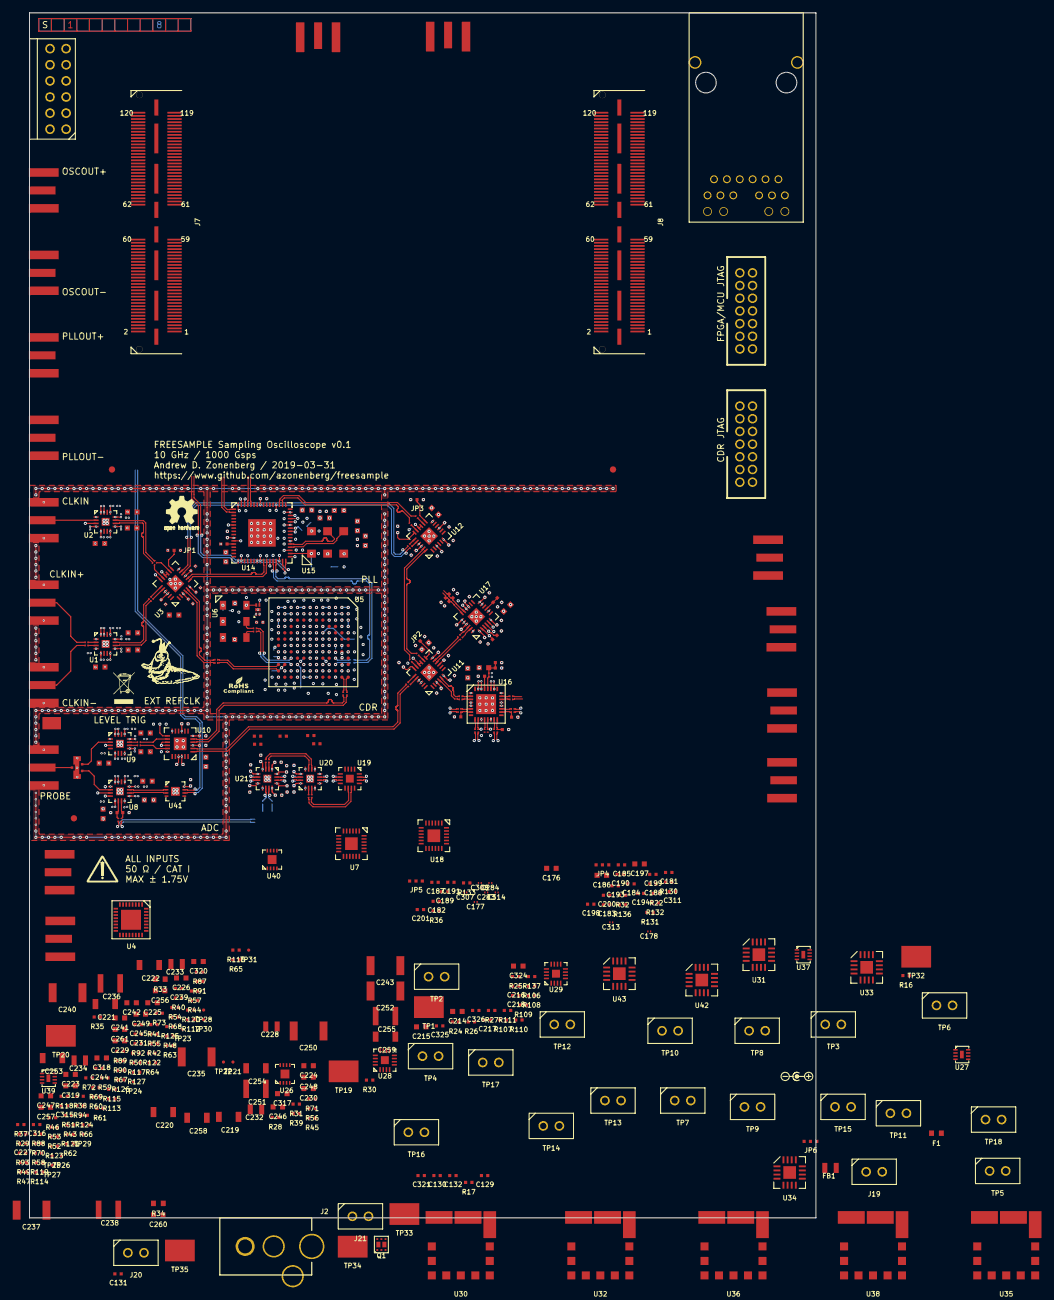
[picture p13: board freesample.kicad_pcb from above]

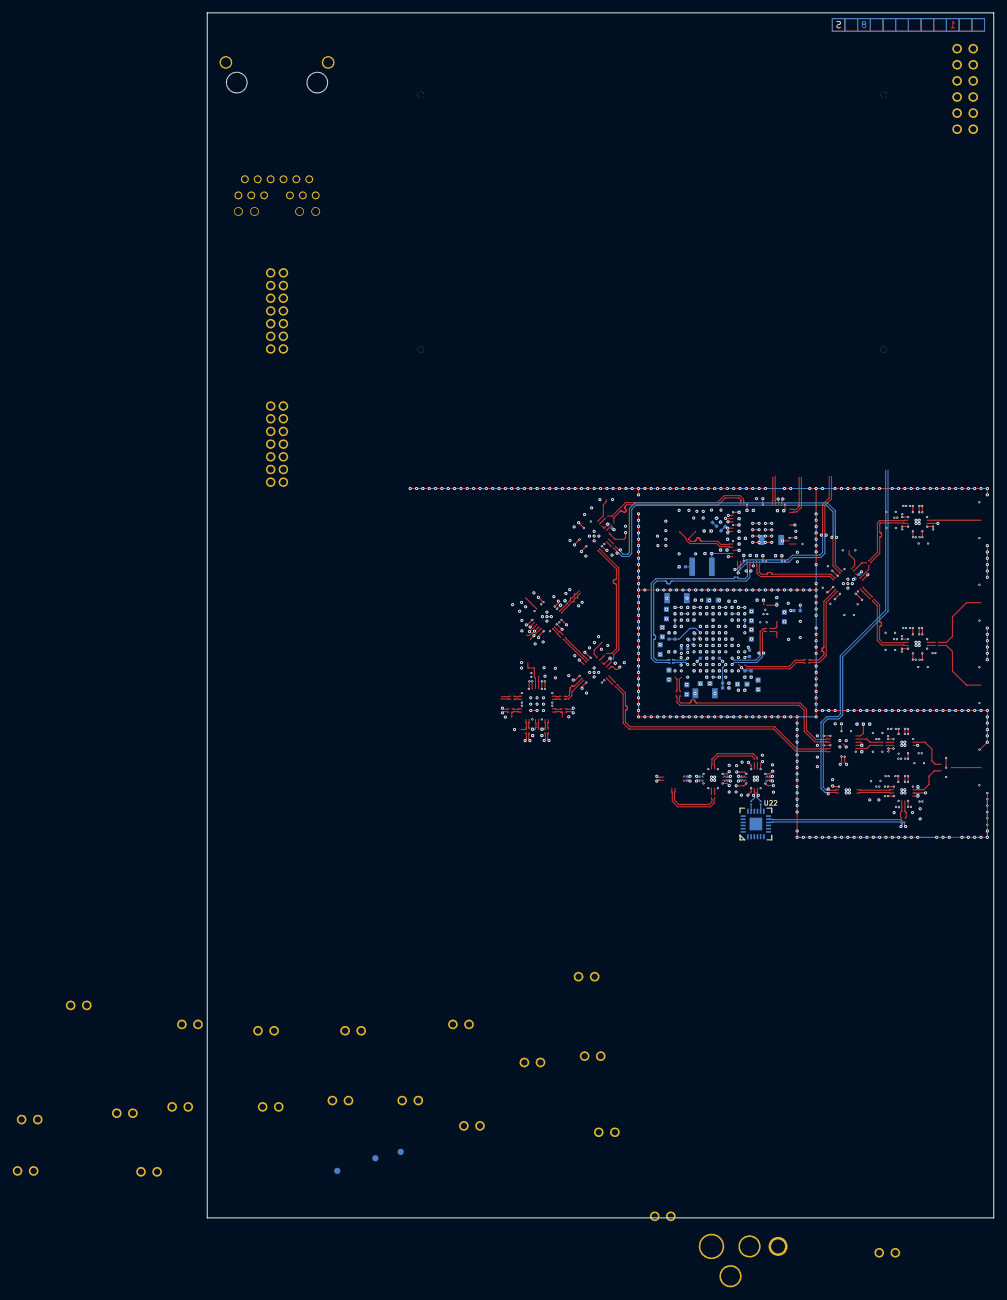
[picture p14: board freesample.kicad_pcb from below]

Board: 8 copper layers, 124.0 x 190.0 mm, 577 parts (109 on the bottom side), 389 nets.
