azonenberg/freesample/boards/cal-1ghz-sine/cal-1ghz-sine.kicad_pcb

## KiCad design boards/cal-1ghz-sine/cal-1ghz-sine.kicad_pcb (2018-12-07)

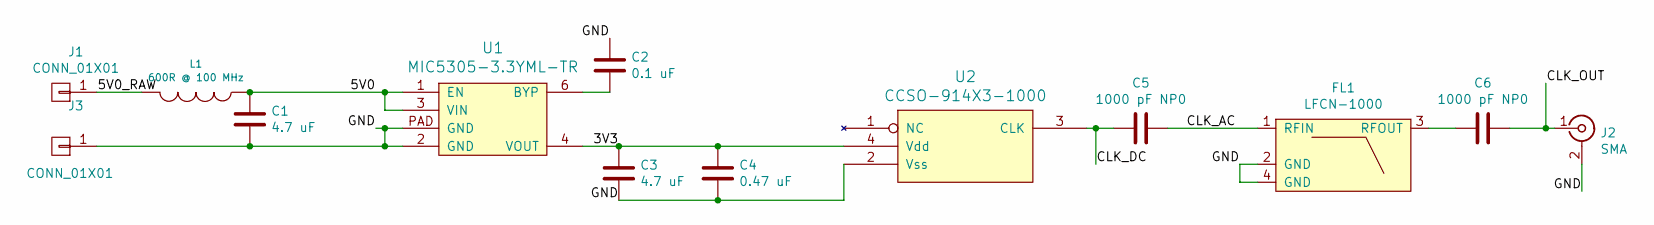
[picture p15: schematic cal-1ghz-sine.sch, FREESAMPLE 1 GHz Calibration Standard]

Parts:
C1, C3: 4.7 uF; EIA_0603_CAP_NOSILK
C2: 0.1 uF; EIA_0402_CAP_NOSILK
C4: 0.47 uF; EIA_0402_CAP_NOSILK
C5, C6: 1000 pF NP0; EIA_0402_CAP_NOSILK
FL1: LFCN-1000; FILTER_MINICIRCUITS_LFCN
J1, J3: CONN_01X01; TESTPOINT_SMT_KEYSTONE_5016
J2: SMA; CONN_SMA_EDGE_SAMTEC_SMA_J_P_H_ST_EM1
L1: 600R @ 100 MHz; EIA_0402_CAP_NOSILK
U1: MIC5305-3.3YML-TR; DFN_6_0.65MM_2x2MM
U2: CCSO-914X3-1000; OSC_CRYSTEK_CCSO-914X3

Connections:
/3V3: C3.1, C4.1, U1.4 (VOUT), U2.4 (Vdd)
/5V0: C1.1, L1.1, U1.1 (EN), U1.3 (VIN)
/5V0_RAW: J1.1, L1.2
/CLK_AC: C5.1, FL1.1 (RFIN)
/CLK_DC: C5.2, U2.3 (CLK)
/CLK_OUT: C6.1, J2.1 (In)
/GND: C1.2, C2.1, C3.2, C4.2, FL1.2 (GND), FL1.4 (GND), J2.2 (Ext), J3.1, U1.2 (GND), U1.PAD (GND), U2.2 (Vss)
unnamed: C2.2, U1.6 (BYP)
unnamed: C6.2, FL1.3 (RFOUT)

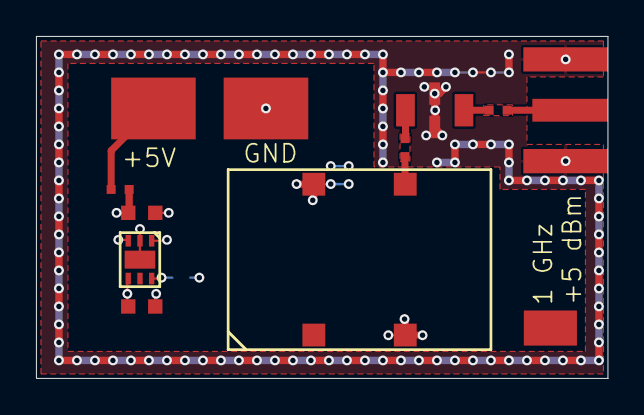
[picture p16: board cal-1ghz-sine.kicad_pcb from above]

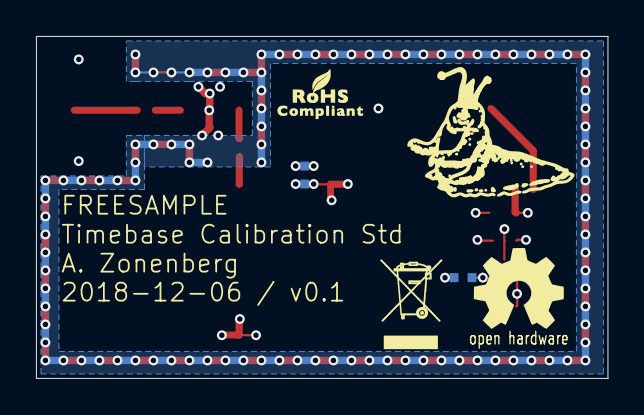
[picture p17: board cal-1ghz-sine.kicad_pcb from below]

Board: 4 copper layers, 31.8 x 19.0 mm, 13 parts (2 on the bottom side), 9 nets.
