azonenberg/freesample/(commit log)

2018-12-05 Initial microstrip layout for cal board
    [cal-1ghz-sine.kicad_pcb, cal-1ghz-sine.sch]
2018-12-07 Finished initial version of cal-1ghz-sine board. Sending to fab.
    [cal-1ghz-sine.kicad_pcb]
2018-12-16 Initial version of main FREESAMPLE board schematic
    [adc.sch, cdr.sch, dac.sch, ext-clocks.sch, freesample.kicad_pcb, freesample.sch, leveltrigger.sch, oneshot.sch]
2018-12-17 Continued initial schematic capture
    [adc.sch, cdr.sch, dac.sch, ext-clocks.sch, freesample.sch, leveltrigger.sch, oneshot.sch, phase-control.sch]
2018-12-23 Continued initial schematic entry
    [leveltrigger.sch]
2019-02-18 Continued work on schematic capture
    [adc.sch, cdr.sch, dac.sch, ext-clocks.sch, freesample.sch, leveltrigger.sch, oneshot.sch, phase-control.sch]
2019-02-24 Continued work on FREESAMPLE schematic including PSU.
    [adc.sch, cdr.sch, dac.sch, ext-clocks.sch, freesample.sch, leveltrigger.sch, oneshot.sch, phase-control.sch]
2019-02-24 Lots more work on PSU and sch readability improvements
    [cdr.sch, oneshot.sch, phase-control.sch, psu.sch]
2019-02-27 Continued work on PSU design
    [psu.sch]
2019-02-27 Hooked up new power rails
    [adc.sch, cdr.sch, dac.sch, ext-clocks.sch, freesample.sch, leveltrigger.sch, oneshot.sch, phase-control.sch]
2019-03-01 Continued PSU design
    [freesample.sch, psu.sch]
2019-03-11 Continued schematic capture work. Hooked up most SoM connectors.
    [adc.sch, cdr.sch, dac.sch, ext-clocks.sch, freesample.sch, leveltrigger.sch, oneshot.sch, phase-control.sch]
2019-03-11 Lots of ERC fixes, added CML-to-LVDS buffers for FPGA input signals
    [adc.sch, dac.sch, freesample.sch, oneshot.sch, phase-control.sch, psu.sch, som.sch]
2019-03-12 Finished PSU schematic. Ready for design review!
    [adc.sch, cdr.sch, dac.sch, ext-clocks.sch, freesample.sch, leveltrigger.sch, oneshot.sch, phase-control.sch]
2019-03-14 Specified part number for AC coupling caps
    [adc.sch, cdr.sch, dac.sch, ext-clocks.sch, freesample.kicad_pcb, freesample.sch, leveltrigger.sch, oneshot.sch]
2019-03-14 Began design review. Added review status checklist with current progress. Added some test points, plus an attenuator on the DAC output to prevent bad firmware from damaging the comparators
    [cdr.sch, dac.sch, phase-control.sch, pll.sch]
2019-03-15 Updated schematic to KiCAD 5.1 release
    [adc.sch, cdr.sch, dac.sch, ext-clocks.sch, freesample.sch, leveltrigger.sch, oneshot.sch, phase-control.sch]
2019-03-16 Added more test points. Started picking packages for passives. Continued schematic review.
    [adc.sch, cdr.sch, dac.sch, ext-clocks.sch, freesample.kicad_pcb, freesample.sch, leveltrigger.sch, oneshot.sch]
2019-03-16 Continued schematic review
2019-03-16 Continued assigning footprints
    [adc.sch, cdr.sch, dac.sch, ext-clocks.sch, freesample.sch, leveltrigger.sch, oneshot.sch, phase-control.sch]
2019-03-16 Continued selecting component footprints and working on schematic review
    [cdr.sch, freesample.sch, psu.sch]
2019-03-17 Continued schematic review. Added more decoupling to DAC
    [dac.sch]
2019-03-17 Continued design review. Added test points on all power rails.
    [psu.sch]
2019-03-17 Continued schematic review. Significantly simplified one-shot to reduce jitter, board area, and power consumption
    [dac.sch, freesample.sch, oneshot.sch, psu.sch, som.sch]
2019-03-17 Continued design review. Changed termination on DFFs to 1V8. Added some pull resistors to keep DFFs in reset during boot.
    [adc.sch, cdr.sch, dac.sch, ext-clocks.sch, freesample.sch, leveltrigger.sch, oneshot.sch, phase-control.sch]
2019-03-17 Continued work on schematic review. Added some more pull resistors.
    [psu.sch]
2019-03-17 Finished schematic review. Added a bunch more test points. Need to make a few footprints then ready for layout!
    [psu.sch, som.sch]
2019-03-17 Added fiducials
    [cdr.sch, dac.sch, freesample.sch, oneshot.sch, pll.sch, psu.sch, sample-clockmux.sch, som.sch]
2019-03-19 Initial layout of external refclks block
    [adc.sch, cdr.sch, dac.sch, ext-clocks.sch, freesample.kicad_pcb, freesample.sch, leveltrigger.sch, oneshot.sch]
2019-03-19 Began layout on clock recovery block
    [cdr.sch, ext-clocks.sch, freesample.kicad_pcb, freesample.sch, pll.sch]
2019-03-21 Finished initial layout of CDR subsystem
    [cdr.sch, freesample.kicad_pcb]
2019-03-21 Moved CDR block down so it's closer to the level trigger
    [adc.sch, cdr.sch, dac.sch, ext-clocks.sch, freesample.kicad_pcb, freesample.sch, leveltrigger.sch, oneshot.sch]
2019-03-21 Swapped clock inputs to TLK10232 to reduce via count. Began PLL layout.
    [adc.sch, cdr.sch, dac.sch, ext-clocks.sch, freesample.kicad_pcb, freesample.sch, leveltrigger.sch, oneshot.sch]
2019-03-21 Finished initial PLL layout
    [freesample.kicad_pcb]
2019-03-21 Tweaks to PLL and CDR layout, swapped a few signals around. Began work on level trigger and ADC layout.
    [ext-clocks.sch, freesample.kicad_pcb, freesample.sch, leveltrigger.sch, pll.sch, sample-clockmux.sch]
2019-03-21 Continued layout on level trigger subsystem
    [freesample.kicad_pcb, leveltrigger.sch]
2019-03-23 Finished initial layout of level trigger and ADC subsystems
    [adc.sch, freesample.kicad_pcb, freesample.sch, leveltrigger.sch]
2019-03-24 Continued layout on clock muxing
    [adc.sch, cdr.sch, dac.sch, ext-clocks.sch, freesample.kicad_pcb, freesample.sch, leveltrigger.sch, oneshot.sch]
2019-03-25 Initial layout of coarse delay line
    [adc.sch, cdr.sch, dac.sch, ext-clocks.sch, freesample.kicad_pcb, freesample.sch, leveltrigger.sch, oneshot.sch]
2019-03-25 Rearranged a bunch of pending stuff in preparation for further layout. Moved SMAs to approximate final locations
    [freesample.kicad_pcb]
2019-03-28 Finished initial layout of delay lines
    [adc.sch, cdr.sch, dac.sch, ext-clocks.sch, freesample.kicad_pcb, freesample.sch, leveltrigger.sch, oneshot.sch]
2019-04-01 Initial layout work on one-shot. Nowhere near done.
    [adc.sch, cdr.sch, dac.sch, ext-clocks.sch, freesample.kicad_pcb, freesample.sch, leveltrigger.sch, oneshot.sch]
